Huliang2597/byd-music1/README.md

# byd-music1

- [显示器挂灯 DIY 制作方案（个人自制版 · 3D 打印）](docs/diy-monitor-light-bar.md)
- [显示器挂灯 3D 打印件（模型和 STL）](cad/README.md)
- [显示器挂灯 产品方案（量产版）](docs/monitor-light-bar-spec.md)
