Huliang2597/byd-music1/docs/monitor-light-bar-spec.md

# 显示器挂灯 产品方案（量产级 v1.0）

> 依据：原始需求 + 三条提问/批注。本文给出可直接进入 EVT 打样的完整方案，所有关键数值都附推导，标「待确认」的项需要在立项会上拍板。
> 器件型号为参考选型，量产前以方案商/原厂规格书和实测为准。

---

## 0. 结论速览（先回答三条提问）

| # | 提问 / 批注 | 结论 |
|---|---|---|
| 1 | 夹具样式？ | **背挂式重力夹（前挂钩 + 后配重臂 + 中间铰链）**，适配屏厚 0.6–3.0 cm、平面屏和 ≥1000R 曲面屏，不夹压面板；阻尼转轴放在灯体与夹具连接处，灯头俯仰 −10°～+25°。顶部带摄像头平台（1/4" 螺孔）的公模优先。详见 §2。 |
| 2 | 要不要氛围灯？装在哪？2812 加进去会超 5V1A | **做成 Pro 版选配，不进基础版。** 位置：**灯体背面朝后上方 30–45°**，打亮显示器后方墙面（Bias Light），用户正面看不到灯珠。功率靠“**分路硬件封顶 + 固件动态分配**”解决：前光硬件上限 655 mA，ARGB 支路硬件限流 ≤180 mA，两者加系统电流在 4.75 V 最坏情况下合计 ≤890 mA，**就算固件跑飞也不会超过 900 mA**。代价是 ARGB 全白最多约 11% 亮度、单色约 34%。作为背景光这个亮度刚好合适（Bias Light 本来就只需要屏幕亮度的 10% 左右）。详见 §4、§5。 |
| 3 | 蓝牙 +25、触摸 +20 | 按 BOM 估算，蓝牙模组含授权约 ¥6–9，触摸（IC + 电极 + CNC 开窗）约 ¥2–4。**批注里的成本若是方案商报价，偏高很多，建议要拆分报价。** 硬件设计成**一套 PCB 兼容 按键 / 触摸 / BLE / ARGB 选贴**，可以按 SKU 分开出货。详见 §7.4、§10。 |

**关键设计决策（摘要）**
1. 前光：48 颗双色温 2835（Ra95 料），**8 串 6 并**，接**一路升压恒流**。冷暖两路用**互补 PWM（重叠，不加死区）** 混色，亮度走**模拟（DC）调光**，所以没有频闪，换色温时总光通也不变。
2. 电源：USB-C 只做 5 V Sink（CC 各接 5.1 kΩ 下拉），输入端有软启动加短路保护，分支各有硬件上限，固件用分流电阻闭环测电流，带 VBUS 跌落自适应降额（兼容只给 500 mA 的 USB2 口）。
3. 无线：**只做 BLE，不做 Wi-Fi**。Wi-Fi 发射峰值约 300 mA 以上，会吃掉三分之一的功率预算，而手机控制用 BLE 已经足够。推荐涂鸦 BLE 模组走 MCU 串口协议，不用自己开发 App，上市最快。
4. 触摸：铝壳上做不了电容触摸，要在**右端顶面 CNC 开窗，嵌 PC 触控盖板**（或者用加长塑料端盖，成本更低）。

---

## 1. 产品定义与规格总表

### 1.1 SKU 规划（建议）

| 配置 | 基础版 | 标准版 | Pro 版 |
|---|---|---|---|
| 前光 3000–6000K Ra≥90 | ● | ● | ● |
| 操控 | 实体按键 ×4 | 电容触摸 ×4 | 电容触摸 ×4 |
| BLE 手机控制 | — | ○（可选） | ● |
| 背光 ARGB | — | — | ● |
| 环境光自动调光（ALS） | — | ○ | ○ |

> 三个版本共用铝型材、夹具、LED 板、电源板，只是控制板选贴不同；端盖或触控窗分两种镶件。

### 1.2 规格总表

| 项目 | 规格 |
|---|---|
| 外形 | 铝槽主体 450 ±0.3 mm，含端盖总长约 456 mm；截面约 26 × 22 mm（以公模图纸为准） |
| 前光有效发光长度 | 400 mm（两端各留 25 mm 放电源板和控制板） |
| 输入 | USB Type-C（Sink），5 V（4.75–5.25 V），**稳态 ≤ 850 mA（固件目标），任何工况 ≤ 900 mA，总功率 ≤ 4.5 W** |
| 前光光源 | 48 × 双色温 2835（3000K + 6000K，单芯 Ra95 / R9≥50），8S6P |
| 色温 | 3000–6000K 无级（App 步进 100K；按键 4 档 + 长按无级） |
| 显色 | 全色温段 Ra ≥ 90（目标 ≥ 92），R9 ≥ 50，Duv 在 ±0.006 以内 |
| 亮度 | 1%–100% 无级，按 CIE 感知曲线（Gamma）映射 |
| 照度目标 | 灯下 45 cm，中心 ≥ 500 lx（6000K 满亮），≥ 420 lx（3000K） |
| 频闪 | 亮度用 DC 调光；IEEE 1789 无风险级，SVM ≤ 0.4，Pst^LM ≤ 1 |
| 蓝光 | IEC/EN 62471（GB/T 20145）RG0 豁免级 |
| 防眩光 | 非对称配光；屏幕面中心由本灯产生的照度 ≤ 30 lx，正视屏幕看不到反射光带 |
| 背光 (Pro) | 20 × WS2812B-2020（或同协议同尺寸），间距 20 mm，朝后上方 30–45°，支路硬件限流 ≤ 180 mA |
| 操控 | 电容触摸 4 键（或实体按键 4 键），BLE 5.x 手机 App，预留实体按键/扩展口 |
| 夹具 | 背挂式重力夹，适配屏厚 0.6–3.0 cm，阻尼转轴俯仰 −10°～+25° |
| 待机功耗 | BLE 版 ≤ 0.05 W；无 BLE 版 ≤ 0.01 W |
| 工作环境 | 0–40 °C，RH ≤ 85% 无凝露；储存 −20–60 °C |
| 寿命 | L70 ≥ 25,000 h（按 TM-21 由 LM-80 数据推算），阻尼转轴 ≥ 5,000 次 |
| 附件 | USB-A 转 C 线 1.5 m（24AWG 电源线）、说明书、保修卡 |

---

## 2. 夹具方案（回答提问 1）

### 2.1 公模样式对比

| 样式 | 原理 | 优点 | 缺点 | 结论 |
|---|---|---|---|---|
| **A. 背挂式重力夹**（前挂钩 + 铰链 + 后配重臂） | 重心落在屏幕背面，靠自重挂在屏幕上沿，铰链自适应屏厚 | 不压面板；适配平面/曲面屏；安装一放即可；公模多 | 后配重臂会碰到屏幕背后凸起很大的机型 | **推荐** |
| B. 弹簧夹 | 弹簧夹住屏幕上沿 | 便宜 | 夹持力直接压在面板上，超薄屏、曲面屏容易压伤或漏光；夹持厚度范围小 | 不推荐 |
| C. 粘贴底座 + 磁吸 | 屏幕背面粘底座 | 最稳 | 要用胶，用户接受度低，拆卸会留胶 | 只作配件 |
| D. A 型 + 顶部摄像头平台 | A 型的夹具顶面做成平台，带 1/4" 螺孔 | 解决“挂灯后摄像头没地方放”的痛点 | 夹具贵 ¥1–2 | **A 型的优选款** |

### 2.2 选型要求（给夹具供应商的规格）

| 项目 | 要求 |
|---|---|
| 适配屏厚 | 0.6–3.0 cm（覆盖绝大多数平面屏；曲面屏 ≥ 1000R） |
| 前挂钩 | 下垂深度 ≤ 8 mm（不遮挡窄边框屏的显示区），厚度 ≤ 3 mm，内侧贴防滑硅胶垫（邵氏 40–50A，厚 1 mm） |
| 后配重臂 | 长度 ≥ 60 mm，接触面带硅胶垫；配重用锌合金或铁块，夹具总重 80–120 g |
| 稳定性 | 灯体加夹具的合重心必须落在屏幕前表面之后 ≥ 5 mm；装好后向前推 15° 不翻落 |
| 阻尼转轴 | 轴线平行于灯体长度方向；俯仰 −10°～+25°；扭矩 0.8 ±0.2 kgf·cm（推导见下）；寿命 ≥ 5,000 次后扭矩衰减 ≤ 30% |
| 灯体连接 | 卡箍或卡槽抱住铝型材中段（型材要有对应卡位），不能在铝面上留压痕 |
| 材料 | PC/ABS（UL94 V-2 及以上）+ 锌合金；表面颜色与铝型材一致 |
| 线缆 | USB 线**不穿过转轴**（避免反复扭转断线），从左端盖直接引出，沿屏幕背后走线 |

**阻尼扭矩推导**：灯体约 0.22 kg，绕转轴的重心偏心按 10 mm 估算，重力矩 = 0.22 × 9.8 × 0.01 ≈ 0.022 N·m ≈ 0.22 kgf·cm。取 3–4 倍安全系数（防止碰一下就掉角度，同时手调起来不费劲），得 0.8 ±0.2 kgf·cm。EVT 阶段用实物称重和实测重心后再修正。

---

## 3. 光学方案（前光）

### 3.1 光源

- **灯珠**：双色温 2835（单颗封装内一颗 3000K 芯 + 一颗 6000K 芯，4 脚），48 颗，间距 8.33 mm。
- **选料要求**：单色温 Ra ≥ 95、R9 ≥ 50。原因：3000K 和 6000K 混出的中间色温会落在普朗克轨迹下方（Duv 偏负），Ra 会掉 2–4 个点，所以单芯要用 95 的料，才能保证全段 ≥ 90。
- **分档**：同一批次同一 Vf 档（档宽 ≤ 0.1 V）、同一色区（3 阶麦克亚当椭圆以内）。Vf 一致决定 6 路并联的均流，色区一致决定整条灯色温均匀。
- **工作点**：单芯约 21 mA（额定 60 mA 的 35%），光效高、温升低、光衰慢。

### 3.2 非对称配光（防屏幕眩光）

挂灯的核心体验：**光只往桌面和键盘区打，不打到屏幕上**。用公模做的实现方式：

1. LED 板在型材里**向用户方向前倾 20°±5°** 安装（型材里要有斜卡槽，选公模时重点核对）。
2. 型材**后侧做 3–5 mm 遮光唇**，挡住射向屏幕的后向光。
3. 前侧做短遮光檐，防止用户直视灯珠（坐姿视线高于灯底面时看不到发光面）。
4. 扩散罩用高雾度 PC（透过率 75–85%，雾度 ≥ 90%）。灯珠到罩的距离 ≥ 6 mm，才能消除 8.3 mm 间距带来的颗粒感。
5. 有条件的可以做微棱镜 PC 罩，压窄光束，更不容易溢光到屏幕上；这属于升级项，要开挤出模。

**验证指标**：显示器 24" 和 27" 两种工况，45 cm 坐姿，屏幕中心照度增量 ≤ 30 lx，熄屏状态下正视屏幕看不到反射光带。

### 3.3 混光与调光原理

```
            ┌────────── 升压恒流 (总电流 I_total 由 DIM 设定, DC 调光) ──────────┐
VBUS 5V ──► │ BOOST ──► V_out ≈ 23 V ──┬── 6 串暖白芯 (8S6P) ── Q_W ──┐          │
            │                          └── 6 串冷白芯 (8S6P) ── Q_C ──┴─ R_sense ─┘
            └──────────────────────────────────────────────────────────────────────┘
   MCU: DIM (PWM→模拟)  → 总亮度
        PWM_W / PWM_C (25 kHz 互补, 重叠 0.2–0.5 µs) → 色温比例 D : (1−D)
```

- **同一时刻只有一路导通**，升压的负载恒定，所以换色温时总功率不变，输入电流不会跳。
- 互补 PWM **用重叠，不用死区**：两路同时关断时恒流环会开路，触发 OVP 尖峰；两路短暂同时导通只是分流，没有坏处。
- PWM 频率 25 kHz：高于可闻频段（陶瓷电容不会啸叫）。暖芯冷芯光效有差别，会带来残余调制，但在这个频率下属于 IEEE 1789 无风险区。
- 亮度用 DC（模拟）调光，1% 以下才切到低频 PWM 补偿，消费者感知层面算“无频闪”。
- **等光通色温**：暖芯光效比冷芯低约 10–15%，固件里存一张色温 → 电流补偿表（产测时校准），保证在 3000K 和 6000K 之间切换时亮度看起来一样。

### 3.4 照度可行性估算

LED 电功率上限 2.8 W，Ra95 料在这个电流下光效约 125 lm/W，得 350 lm；扩散罩加遮光损失约 20%，出光约 280 lm。非对称光束集中在约 60 × 35 cm 的桌面区，利用率按 0.6 计，平均照度约 800 lx，中心 ≥ 500 lx 有裕量。**EVT 阶段要用配光曲线仪实测确认。**

---

## 4. 背光氛围灯方案（回答提问 2）

### 4.1 要不要做

- **功能价值**：真正有用的是 Bias Light（屏后背景光），它能降低屏幕和暗墙之间的明暗反差，减轻暗室用屏的视疲劳；RGB 灯效主要是电竞桌搭的颜值卖点。
- **建议**：**只在 Pro 版做**。基础版和标准版不贴 ARGB，PCB 和型材共用（背光罩改成同色盲条）。
- **默认模式设为“护眼背光”**：6500K 近似白、10–20% 亮度；RGB 灯效（流水、呼吸、静态色）作为可选模式。

### 4.2 位置

```
          用户 ◄────────── 前                     后 ──────────► 墙
                       ┌──────────────────────────┐
                       │      铝型材 (顶面)        │  ╲ 背光 PC 罩
          遮光檐 ─┐     │                          │   ╲  ARGB 朝后上方 30–45°
                  └──── │  前倾 20° LED 板          │    ↗↗  打亮显示器后方墙面
                       └──┬──── 扩散罩 ────┬──────┘
                          ↓↓  光打向桌面    └ 后遮光唇（挡屏幕方向的光）
                    ═══════════ 显示器上沿 ═══════════
```

- 在灯体**背面**开一条独立灯槽（要求公模是“双面出光”型材，**选型时必须确认**），装 ARGB FPC 和乳白 PC 罩。
- 朝向后上方 30–45°：光打到显示器后上方的墙面，用户坐姿看不到灯珠，也不会照进眼睛或打到屏幕上。
- 灯珠：WS2812B-2020（2 × 2 mm，适配窄槽），20 颗，间距 20 mm，覆盖 400 mm。

### 4.3 功率问题怎么解决

你的判断是对的：WS2812B 单颗全白约 60 mA（每通道约 20 mA），20 颗全白就是 1.2 A，单这一路就超过整机预算。方案如下：

1. **硬件封顶**：ARGB 的 5 V 走一颗**可调限流负载开关**（TPS2553 / SY6280 类，限流设定 ≈160 mA，最大 ≤180 mA）。固件失效时 ARGB 也吃不到 180 mA 以上。关闭氛围灯时直接断电，顺带消掉 20 颗灯珠的静态电流（约 10–20 mA）。
2. **固件封顶 150 mA**：固件按 `I ≈ N × I_q + Σ(R+G+B)/255 × I_ch` 估算电流（I_ch 产测时标定），超出就整体等比缩放亮度。
3. **能做到的亮度**：150 mA 扣掉静态电流后约 135 mA 可用，相当于全白约 11%、单色约 34%。作为背景光这已经够亮；墙面亮度太高反而会刺眼。
4. **如果市场要求更亮的 ARGB**（待确认）：可以换成“ARGB 硬件限流 300 mA + 前光硬件上限降到 2.3 W”的配置，代价是前光照度下降约 18%。不建议这样做。

### 4.4 电平兼容（容易踩的坑）

WS2812B 在 5 V 供电时 VIH = 0.7 × VDD = 3.5 V，**3.3 V 的 MCU 直接驱动处在临界区**，低温或者 VBUS 偏高时会乱码。必须加一颗 **74AHCT1G125**（5 V 供电，TTL 输入电平），串 33 Ω 电阻后再进第一颗灯。每颗灯珠旁放 100 nF 去耦电容。

---

## 5. 电源架构与功率预算（核心）

### 5.1 USB-C 输入

| 项目 | 设计 |
|---|---|
| 角色 | Sink only，CC1 / CC2 各接 **5.1 kΩ 下拉（Rd）**。不接的话 C-to-C 线插充电头不会出电，这是最常见的设计缺陷 |
| 连接器 | 6P 或 16P 卧式 Type-C 母座，插拔寿命 ≥ 10,000 次（6P 只有 VBUS/GND/CC，够用且更便宜） |
| 来源识别 | MCU 的 ADC 读 CC 电压：0.25–0.61 V 为 Default USB，0.70–1.16 V 为 1.5 A，1.31–2.04 V 为 3.0 A。即使检测到 1.5 A 或 3 A，**也按规格封顶 900 mA** |
| 浪涌 | USB 规范要求上电瞬间 VBUS 端容值 ≤ 10 µF：VBUS 口只放 4.7 µF，后级大电容放在带软启动的负载开关后面 |
| 保护 | VBUS 上放 TVS（5 V 单向，如 SMF5.0A），CC 和 D± 上放 ESD 阵列；输入负载开关带软启动和短路保护（约 1.1 A 动作，自动重试） |
| 电流检测 | 50 mΩ 分流电阻 + INA180A2（增益 50）→ ADC，900 mA 对应 2.25 V；分流电阻损耗 40 mW |
| 电压检测 | VBUS 经 100k/100k 分压 → ADC |

### 5.2 “硬件 + 固件 ≤ 900 mA”的实现

**这里需要统一对规格的理解**：在输入端放一个精确卡在 900 mA 的 eFuse，会因为器件 ±10% 的公差频繁误动作（用户看到的就是灯一闪一闪）。所以本方案这样实现“硬件限流 ≤ 900 mA”：

> **每条支路各自有硬件上限，最坏工况（VBUS 4.75 V、固件跑飞）下三路合计 ≤ 900 mA**；输入负载开关只负责短路保护；固件闭环把稳态电流控制在 850 mA 以内。

| 负载 | 硬件上限手段 | VBUS = 5.00 V | VBUS = 4.75 V |
|---|---|---|---|
| 系统（MCU + BLE + 触摸 + LDO + 指示灯） | — | 20 mA | 20 mA |
| 前光（LED 2.8 W 输出 + 镇流 0.05 W，升压 η ≈ 87%） | R_sense 定死 LED 最大电流 | 655 mA | 690 mA |
| 背光 ARGB（Pro） | 限流开关 ≤ 180 mA | 150 mA（固件上限） | 150 mA |
| **合计，固件正常** | | **825 mA / 4.13 W** ✓ | 860 mA → 固件把前光压到约 98%，回到 850 mA |
| **合计，固件失效最坏** | | 855 mA ✓ | **890 mA ✓（≤ 900）** |

推导：前光输入功率 = (2.8 + 0.05) / 0.87 = 3.28 W；在 5.00 V 下为 655 mA，在 4.75 V 下为 690 mA。

### 5.3 固件功率仲裁

- 10 ms 周期读一次输入电流，PI 闭环。目标 ≤ 850 mA，优先级：**系统 > 前光 > ARGB**（用户主动调 ARGB 时，先在 ARGB 自身 150 mA 上限内缩放，不去抢前光）。
- **VBUS 跌落自适应（兼容 USB2 口 500 mA）**：显示器上的 USB-A 口很多是 USB2（500 mA），线里的 56 kΩ 上拉只能告诉设备是“Default”，区分不了 500 mA 和 900 mA。所以：
  - VBUS < 4.60 V 持续 200 ms：前光每 100 ms 降 5%，直到 VBUS 回到 4.65 V 以上；
  - VBUS < 4.40 V：直接进入 **500 mA 兼容档**（前光 ≤ 380 mA，约 58% 亮度；ARGB ≤ 80 mA），指示灯慢闪 3 次提示；
  - 兼容档会被记住，下次上电按兼容档启动，30 s 后再试探性升档。
- 用户也能手动切“低功耗模式”（App 开关，或 K1 + K3 长按 3 s）。
- **过温**：LED 板中部放 NTC，> 65 °C 开始线性降额，> 80 °C 关前光（按估算，正常不会触发）。

### 5.4 电源树

```
USB-C VBUS ─ TVS ─ 分流 50 mΩ ─ 输入负载开关(软启动/短路保护) ─┬─ 升压恒流 ── 前光 8S6P ×2 路
                                                              ├─ 限流开关 ≤180 mA ── ARGB ×20 (Pro)
                                                              └─ LDO 3.3 V (ME6211) ── MCU / BLE / 触摸 / 运放
```

- 3.3 V 支路只有约 20 mA，用 LDO（ME6211C33）就够，比 Buck 便宜也更安静。**如果以后要做 Wi-Fi 版，必须换 Buck**（Wi-Fi 峰值 300 mA 以上）。
- **关灯微亮（鬼火）**：升压关断后 VOUT ≈ VBUS ≈ 5 V，而 8 串 LED 的 Vf ≈ 23 V，所以完全不会导通，从拓扑上消除了鬼火。

---

## 6. 电子硬件设计

### 6.1 系统框图

```
┌────────────── 左端 25 mm：电源板 (FR4 2L 1.0 mm) ──────────────┐   ┌──── 400 mm LED 铝基板 (1.0 mm, 单面) ────┐
│ USB-C 6P │ TVS/ESD │ 分流+INA180 │ 负载开关 │ 升压恒流 + 电感 │──►│ 48 × 双色温 2835, 8S6P × 2 路, 镇流电阻, NTC │
│ CC 5.1k×2 │ VBUS 分压 │ 3.3 V LDO │ Q_W / Q_C / R_sense         │   └─────────────────────────────────────────┘
└───────────────▲──────────── 8P 0.5 mm FFC / 线束 ──────────────┘
                │ 3V3, GND, DIM, PWM_W, PWM_C, ISENSE, VBUS_S, NTC
┌───────────────┴─ 右端 25 mm：控制板 (FR4 2L 1.0 mm) ─────────────────────────────┐
│ MCU (PY32F003) │ BLE 模组 (UART, 选贴) │ 触摸 IC 4 键 (选贴) / 实体按键焊盘 │ 指示灯 ×4 │
│ 74AHCT1G125 + ARGB 限流开关 (选贴) ──► 背面 ARGB FPC 20 × WS2812B-2020           │
│ SWD 测试点 │ 扩展口焊盘 (2 × GPIO + 3V3 + GND, 用于外接按键/旋钮)                  │
└────────────────────────────────────────────────────────────────────────────────┘
```

> 电源板和控制板分别放在两端，也让整灯左右重量基本平衡，挂在夹具上不会往一边偏。

### 6.2 关键器件选型（参考）

| 功能 | 参考型号 | 关键参数 / 理由 | 国产替代 |
|---|---|---|---|
| 主控 MCU | PY32F003（Cortex-M0+ 32 MHz） | 定时器互补 PWM、SPI（模拟 WS2812 时序）、12 位 ADC × 4、UART；单价 ¥0.3–0.6 | 本身即国产；或 CH32V003、STM32G030 |
| 升压恒流 | TPS61169 类 | 输入 2.7 V 起，开关管 40 V / 1.2 A，OVP 约 38 V，CTRL 脚 PWM 转模拟调光，FB 0.2 V | 由方案商确认 pin-to-pin 国产料 |
| R_sense | 1.6 Ω 1% 0805 | 0.2 V / 125 mA，**决定前光硬件上限** | — |
| 电感 | 10 µH，I_sat ≥ 1.5 A，DCR ≤ 100 mΩ，4 × 4 mm | 高度 ≤ 3 mm（受型材内腔限制） | 顺络、麦捷 |
| 整流管 | SS14 / 40 V 1 A 肖特基 | — | — |
| 输出电容 | 2.2 µF / 50 V X7R × 2 | 耐压按 OVP 选 | — |
| 色温开关 Q_W / Q_C | 30 V N-MOS，SOT-23，R_DS(on) ≤ 100 mΩ @ 2.5 V | 由 MCU 3.3 V 直接驱动 | AO3400 类 |
| 输入负载开关 | 带软启动的 USB 限流开关，约 1.1 A | 短路保护、控制浪涌 | 矽力杰 / 韦尔 |
| ARGB 限流 | TPS2553 / SY6280 类可调限流开关，≈160 mA | 硬件封顶 + 关断时断电 | — |
| 电流检测 | INA180A2 + 50 mΩ 1% | 分流电压放大 | 圣邦微、思瑞浦 |
| LDO | ME6211C33 | 500 mA，Iq 约 40 µA | — |
| 触摸 IC | 4 键触摸 IC（TTP224 或合泰 BS83A04A 类） | 自校准、灵敏度可调、带防水算法的优先 | 本身即国产 |
| BLE | 涂鸦 BLE 模组（Telink TLSR825x 方案） | 发射电流约 10 mA 级，涂鸦 MCU 串口协议，自带 App，支持 OTA | 也可用 ESP32-C3（要自研 App） |
| 电平转换 | 74AHCT1G125 | 3.3 V → 5 V，驱动 WS2812 | — |
| ARGB 灯珠 | WS2812B-2020 × 20 | 窄槽；电流以规格书为准，预算按 20 mA/通道保守计算 | 晶能、普瑞等同协议灯珠 |
| NTC | 10 kΩ B3950 0603 | 放在 LED 板中部 | — |

### 6.3 LED 铝基板

- 尺寸 400 × 8–10 mm（宽度按型材卡槽定），1.0 mm 厚铝基，导热 ≥ 1.0 W/m·K，单面；白油。
- 走线：每颗双色温灯珠的暖芯和冷芯分属两路；6 个并联串**按空间交错排布**，这样即使某一串偏暗，也是均匀分散的，不会出现一段暗区。
- 每串串 20 Ω 镇流电阻（20 mA 时压降 0.4 V，功耗 8 mW），配合同一 Vf 档，均流误差可以压到 ±5% 以内。
- 端子：两端焊盘直接焊线（或板对线连接器）接电源板，NTC 信号也走这条线。

### 6.4 PCB 设计要点 checklist

- [ ] 升压环路（开关管 → 电感 → 二极管 → 输出电容 → 地）面积最小，地平面完整，FB 走线远离电感。
- [ ] R_sense 用开尔文连接；用 1% 精度；它决定硬件上限，BOM 里标成**关键件，禁止替代**。
- [ ] CC 下拉 5.1 kΩ 用 1%。
- [ ] 触摸电极：8 × 8 mm，键间距 ≥ 15 mm，电极距离铝壳 ≥ 3 mm，触摸走线最短，不与 PWM 走线平行；敷铜用网格地。
- [ ] 铝壳通过 USB 外壳接 GND（ESD 泄放路径），触摸 IC 的灵敏度在装壳后标定。
- [ ] 控制板上 BLE 天线的净空区（按模组手册）要对准塑料件区域，**不能被铝壳包住**（天线位置放到触控窗或端盖下方，否则距离会掉到 1–2 m）。
- [ ] 预留 SWD、UART 测试点，以及产测针床定位孔。

---

## 7. 操控与交互

### 7.1 触摸区位置

铝是导体，**没法隔着铝壳做电容触摸**。两个方案：

| 方案 | 做法 | 成本 | 外观 |
|---|---|---|---|
| **A（推荐）** | 右端顶面 CNC 铣窗 70 × 10 mm，嵌入 1.5 mm 厚 PC 触控盖板（背面丝印图标，透光孔下面放指示灯） | CNC ¥1–2 + 盖板 ¥0.5 | 一体感强，接近一线品牌 |
| B（降本） | 右端盖加长做成 30 mm 的塑料件，触摸键做在端盖顶面 | ≈ ¥0 增量（改端盖模） | 端盖较长，按键较挤 |

基础版：同一位置换成实体按键盖板，下面放 4 颗 3 × 4 mm 侧按/顶按轻触开关（寿命 ≥ 100,000 次）。

### 7.2 按键定义（触摸版与实体按键版逻辑一致）

| 键 | 短按 | 长按 | 其他 |
|---|---|---|---|
| K1 ⏻ 电源 | 开/关（300 ms 渐变） | 5 s：进入 BLE 配网（指示灯快闪） | K1 + K2 长按 8 s：恢复出厂 |
| K2 ☀ 亮度 | 循环 20 / 50 / 80 / 100% | 无级调光，每次长按方向交替，到顶/到底闪一下 | — |
| K3 🌡 色温 | 循环 3000 / 4000 / 5000 / 6000K | 无级调色温，方向交替 | K1 + K3 长按 3 s：低功耗模式开/关 |
| K4 ✦ 氛围灯（Pro） | 开/关 | 调氛围灯亮度 | 双击：切换模式（护眼背光 → 静态色 → 呼吸 → 流水） |

- **防误触**：按住 50 ms 才判定有效；≥ 3 个键同时触发视为擦拭或手掌误触，直接忽略；上电后 1 s 内触摸 IC 自校准，期间不响应。
- **指示灯**：每键下面一颗 0603 暖白 LED，≤ 1 mA，开灯后 5 s 自动降到 10% 亮度（避免夜间刺眼），可以在 App 里关掉。

### 7.3 手机端（BLE）

**推荐方案：涂鸦 BLE 模组 + MCU 串口协议**（MCU 负责全部灯控逻辑，模组只做透传和云端/App 对接）。

- 优点：不用开发 App（用“涂鸦智能 / 智能生活”App，也可以做自有品牌 OEM App）；自带 OTA、定时、场景；可以接入涂鸦生态的语音音箱联动（通过网关）。
- DP 点规划（参考涂鸦照明品类标准 DP，以平台最新定义为准）：

| DP | 功能 | 类型 | 范围 |
|---|---|---|---|
| 20 switch_led | 前光开关 | bool | — |
| 21 work_mode | 模式（白光/场景） | enum | white / scene |
| 22 bright_value | 前光亮度 | value | 10–1000 |
| 23 temp_value | 色温 | value | 0–1000（映射 3000–6000K） |
| 25 scene_data | 场景（阅读/办公/观影/夜间） | string | — |
| 26 countdown | 倒计时关灯 | value | 0–86400 s |
| 自定义 | 氛围灯开关 / 模式 / 颜色 / 亮度 / 速度 | bool / enum / string / value | — |
| 自定义 | 低功耗模式、指示灯开关、休息提醒（每 45 min 闪一下提醒起身） | bool / value | — |

- 备选方案 1：ESP32-C3 单芯片（BLE 加可选 Wi-Fi）加自研小程序/App，适合要做自有生态的情况，开发周期多 6–8 周。
- 备选方案 2：米家生态，需要走小米认证和合作流程，周期长，适合有渠道资源的情况。

### 7.4 关于“蓝牙 +25 / 触摸 +20”的成本批注

| 项 | 批注 | 本方案 BOM 估算 | 说明 |
|---|---|---|---|
| 蓝牙 | +25 | ¥6–9 | 模组 ¥5–7 + 涂鸦授权约 ¥1 + 天线净空带来的结构影响 ≈ 0；另有一次性费用：SRRC/认证、OEM App 开通 |
| 触摸 | +20 | ¥2–4 | 触摸 IC ¥0.3–0.8 + 电极/盖板 ¥0.5–1 + CNC 开窗 ¥1–2 |

- 如果 +25 / +20 是**零售价增量**，那是合理的定价策略；如果是**方案商的成本报价**，建议按上表要求拆分报价，或者改为自研硬件、只采购模组。
- 实体按键成本约 ¥1–2，适合基础版。三个版本共用控制板，只是选贴不同，**不额外开板**。

---

## 8. 固件设计

### 8.1 模块

| 模块 | 内容 |
|---|---|
| 启动 | 上电 → 读 Flash 配置 → 读 CC 和 VBUS 判断来源 → 触摸自校准 → 按“掉电记忆”恢复上次状态（可设为默认关灯） |
| 灯控 | 亮度 Gamma 表（CIE 1931 L*）、色温混光比 D 的查表、等光通补偿表（产测写入）、300 ms 渐变、1% 以下低亮补偿 |
| 功率仲裁 | 10 ms PI 环，见 §5.3 |
| ARGB | SPI 输出 WS2812 时序（2.4–3.2 MHz SPI，每 bit 用 3–4 个 SPI bit 编码），30 fps 刷新；功率模型缩放；关闭时断电 |
| 输入 | 触摸 IC 输出（或按键 GPIO）去抖、短按/长按/双击/组合键状态机 |
| 通信 | 涂鸦 MCU 串口协议（9600 / 115200 bps），心跳、DP 上报、配网、OTA（模组 OTA + MCU 固件经模组透传升级） |
| 存储 | Flash 模拟 EEPROM，磨损均衡；最后一次操作 3 s 后才写入 |
| 保护 | 过流（> 1 A 立即关输出后重试）、过温降额、VBUS 欠压降额/兼容档、看门狗 |
| 产测模式 | 上电 2 s 内串口收到特定指令进入：逐路点亮、写校准系数、读传感器、测 BLE RSSI |

### 8.2 状态与默认值

- 出厂默认：4000K、70% 亮度、ARGB 关、指示灯开、掉电记忆开。
- 自动关灯：可选 2 h / 4 h / 关闭（App 设置），默认关闭。

---

## 9. 结构设计

### 9.1 铝型材（公模选型要点）

选公模型材时**必须逐条核对**，不满足的就要开私模（私模挤出模约 ¥3,000–8,000，周期 2–3 周，比较便宜，可以考虑）：

- [ ] 外形约 26 × 22 mm 以内，壁厚 ≥ 1.0 mm，材料 6063-T5。
- [ ] 底部有**前倾 15–25° 的 LED 板卡槽**和扩散罩卡槽。
- [ ] 后侧有遮光唇（3–5 mm）。
- [ ] Pro 版需要**背面第二灯槽**（双面出光型材）。
- [ ] 内腔能放下 25 mm 长、高度 ≤ 4 mm 器件的控制板和电源板。
- [ ] 中段有夹具卡位（或卡箍能抱住的外形）。
- [ ] 表面处理：喷砂 + 阳极氧化（深空灰/银/黑），膜厚 ≥ 10 µm，中性盐雾 24 h 无腐蚀。
- [ ] 直线度 ≤ 0.5 mm / 450 mm，切口无毛刺；触控窗由 CNC 加工，开窗后再氧化。

### 9.2 其他结构件

| 件 | 材料 / 工艺 | 要点 |
|---|---|---|
| 前光扩散罩 | 挤出 PC，雾度 ≥ 90%，透过率 75–85%，UL94 V-2 | 和型材长度一致，两端由端盖压住 |
| 背光罩（Pro） | 挤出乳白 PC | 非 Pro 版换成同色盲条 |
| 左端盖 | PC/ABS 注塑，UL94 V-0 | USB-C 开孔，与母座间隙 ≤ 0.2 mm；用卡扣加 1 颗自攻螺钉固定，防止插拔时把端盖带出来 |
| 右端盖 | PC/ABS 注塑 | 方案 B 时加长并集成触摸面 |
| 触控盖板 | PC 1.5 mm，背面丝印 + 透光孔 | 用 3M 双面胶加卡位固定，平面度 ≤ 0.1 mm（影响触摸灵敏度一致性） |
| 夹具 | 公模，见 §2 | 来料检验扭矩和配重 |
| 内部固定 | 控制板和电源板插入型材内槽，背面贴导热/缓冲泡棉 | 敲击无异响 |

### 9.3 重量目标

灯体约 200–230 g（型材约 135 g、罩约 20 g、PCB 约 30 g、端盖约 15 g、其他约 20 g），夹具 80–120 g，整机 ≤ 350 g。

---

## 10. BOM 与成本估算（1k–5k 量级，含税估算，仅供立项参考）

| 类别 | 项目 | 基础版 | 标准版 | Pro 版 |
|---|---|---|---|---|
| 结构 | 铝型材 450 mm + 氧化（+ CNC 开窗） | 6–8 | 7–9 | 7.5–9.5（双槽型材） |
| 结构 | 扩散罩 / 背光罩 / 端盖 ×2 / 盖板 | 2.5–3.5 | 3–4 | 3.8–5 |
| 结构 | 重力夹具（公模，含配重、硅胶、阻尼） | 8–15 | 8–15 | 8–15 |
| 光源 | LED 铝基板 + 48 颗双色温 2835 Ra95 | 5–8 | 5–8 | 5–8 |
| 电子 | 电源板（USB-C、保护、升压、检测、LDO） | 4–6 | 4–6 | 4–6 |
| 电子 | 控制板（MCU、按键或触摸、指示灯） | 1.5–2.5 | 2–3.5 | 2–3.5 |
| 电子 | BLE 模组 + 授权 | — | (6–9) | 6–9 |
| 电子 | ARGB（20 颗 + FPC + 限流开关 + 电平转换） | — | — | 4–6 |
| 附件 | USB-A 转 C 线 1.5 m | 2–3 | 2–3 | 2–3 |
| 包装 | 彩盒、内托、说明书、保修卡 | 3–5 | 3–5 | 4–6 |
| 制造 | SMT、组装、产测、老化、良损 | 4–6 | 4–6 | 5–7 |
| **合计** | | **≈ ¥36–57** | **≈ ¥38–60**（含 BLE ¥44–69） | **≈ ¥51–78** |

> 一次性费用（不计入单价）：认证（见 §11）约 ¥3–6 万；私模型材（如需要）¥0.3–0.8 万；端盖注塑模 ¥1–2 万；产测治具 ¥0.5–1 万；涂鸦 OEM App（可选）按平台报价。

---

## 11. 认证与测试

### 11.1 认证（按销售市场勾选，待确认）

| 市场 | 项目 |
|---|---|
| 中国 | SRRC 型号核准（BLE 版，选已认证模组可以简化流程）；灯具安全/EMC 按 GB 7000.1、GB 7000.201、GB/T 17743 自测或做 CQC 自愿认证；RoHS；**CCC 是否适用，要按最新目录和 USB 低压供电的情况向检测机构确认** |
| 欧盟 | CE：EMC（EN 55015 / EN 61547）、RED（EN 300 328、EN 301 489-1/-17，BLE 版）、EN 60598-1 / -2-1、EN 62471、RoHS、ErP（待机） |
| 美国 | FCC Part 15B（基础版）/ 15C（BLE 版）；可选 UL 153 / UL 8750 |
| 其他 | 日本 TELEC、韩国 KC 等按需 |

### 11.2 设计验证（DVT）测试清单

| 类别 | 项目 | 判定 |
|---|---|---|
| 光学 | 照度分布（45 cm 平面，10 cm 网格） | 中心 ≥ 500 lx，60 × 30 cm 区域均匀度 ≥ 0.6 |
| 光学 | 色温 / Ra / R9 / Duv（3000/3500/…/6000K 共 7 点） | Ra ≥ 90、R9 ≥ 50、Duv ±0.006，色温误差 ±150K |
| 光学 | 屏幕溢光 | 屏幕中心照度增量 ≤ 30 lx，熄屏时无反射光带 |
| 光学 | 频闪（全亮度段扫描） | SVM ≤ 0.4，Pst^LM ≤ 1 |
| 光学 | 蓝光危害 | RG0 |
| 电气 | 输入电流：全亮度 × 全色温 × ARGB 全模式 × VBUS 4.75/5.0/5.25 V | 稳态 ≤ 850 mA，峰值 ≤ 900 mA |
| 电气 | 故障注入：MCU 复位保持 / DIM 和 PWM 强拉高 / ARGB 数据全白 | ≤ 900 mA（验证硬件封顶） |
| 电气 | USB2 500 mA 口、各类笔记本 / 显示器 / 充电头（≥ 20 款）兼容性 | 不掉电、不闪烁，能正确进入兼容档 |
| 电气 | C-to-C 线 + PD 充电头 | 能出电（验证 5.1 kΩ Rd） |
| 电气 | ESD IEC 61000-4-2 | 接触 ±6 kV / 空气 ±8 kV 判 A 级（触摸区和 USB 口重点打） |
| 电气 | 短路、LED 开路（OVP）、热插拔 1,000 次 | 不损坏、自动恢复 |
| 热 | 25 °C 和 40 °C 环境满功率 4 h | 外壳 ≤ 45 °C（手可接触面），LED 焊点 ≤ 75 °C |
| 无线 | BLE 距离（灯挂在显示器上） | 开阔环境 ≥ 10 m |
| 触摸 | 灵敏度一致性、手汗/湿手、充电器共模干扰（3 Vrms，IEC 61000-4-6） | 无误触，无漏触 |
| 可靠性 | 高温高湿 40 °C / 93% RH 96 h、高低温循环 −20～60 °C 20 次 | 功能正常，外观无异常 |
| 可靠性 | 阻尼转轴 5,000 次、夹具开合 3,000 次、USB 插拔 5,000 次、按键 100,000 次 | 扭矩衰减 ≤ 30%，功能正常 |
| 可靠性 | 包装跌落（ISTA 1A）、运输振动 | 无损坏、无异响 |
| 寿命 | LED 光衰（LM-80 数据 + 整灯 1,000 h 点亮） | L70 ≥ 25,000 h |

---

## 12. 生产与产测

### 12.1 工艺流程

```
来料检验 (LED 分档/夹具扭矩/型材尺寸与膜厚) → SMT (LED 铝基板, 电源板, 控制板)
→ MCU 烧录 + BLE 授权写号 → 板级 ICT/FCT → 总装 (板入型材, 罩, 端盖, 盖板)
→ 整机 FCT → 老化 (满功率 4 h, 循环开关) → 整机复测 → 外观检 → 包装 (夹具分装)
```

### 12.2 整机 FCT 治具（每台都测，单台节拍 ≤ 30 s）

1. 4 个工况下输入电流（关灯 / 3000K 100% / 6000K 100% / Pro 版前光 100% + ARGB 全白），和标准值比较，偏差 ±5%。
2. 照度和色温点检：治具暗箱里放照度计 + 色彩传感器，测 3000K 和 6000K 两点，并**写入等光通补偿系数**。
3. ARGB：相机或色彩传感器检测 R / G / B / 白四种画面，确认无死灯。
4. 触摸：铜柱模拟手指逐键点按，读取触摸 IC 的原始值，确认在窗口内。
5. BLE：读 RSSI，确认在标准值 ±6 dB 以内，并确认授权码写入成功。
6. 掉电记忆：设置后断电再上电，确认状态正确。

### 12.3 关键质量控制点

- LED：每批核对 Vf / 色区分档标签，**禁止混档**；首件做积分球测试。
- R_sense、CC 下拉电阻、限流开关的限流电阻列为关键件，替代必须走 ECN 并重测 §11.2 的电流项。
- 夹具：每批抽检扭矩（0.8 ±0.2 kgf·cm）和挂钩下垂深度。

---

## 13. 开发计划（参考，约 14–16 周到量产）

| 阶段 | 周期 | 产出 |
|---|---|---|
| 立项 / 选型 | W1–W2 | 敲定 §14 待确认项；锁定型材和夹具公模；索取 LED 样品和规格书 |
| EVT | W3–W6 | 原理图 + PCB 第一版、手板（公模加 CNC）；光学实测，调整 LED 前倾角和遮光唇；功率预算实测 |
| DVT | W7–W10 | PCB 第二版、端盖模具 T1、固件功能完整、App 面板；§11.2 全项测试；送认证 |
| PVT | W11–W13 | 小批量 200–500 台试产，验证治具、节拍、良率（目标 ≥ 97%） |
| MP | W14+ | 量产 |

---

## 14. 待确认项（立项会清单）

| # | 事项 | 建议 |
|---|---|---|
| 1 | SKU 组合与目标零售价 | 三档：基础 / 标准 / Pro |
| 2 | 是否保留 ARGB；ARGB 亮度上限取 180 mA 还是 300 mA | Pro 版保留，180 mA |
| 3 | 无线方案：涂鸦 BLE / ESP32-C3 自研 / 米家；是否需要 Wi-Fi | 涂鸦 BLE，不做 Wi-Fi |
| 4 | 触摸位置：CNC 开窗 / 加长端盖 | CNC 开窗 |
| 5 | 型材：现有公模是否满足 §9.1；是否开私模 | 先找双面出光公模，找不到就开私模 |
| 6 | 夹具：是否要摄像头平台款 | 要 |
| 7 | 是否加环境光传感器自动调光（+¥1–1.5） | 标准版和 Pro 版可选 |
| 8 | 销售市场与认证范围 | 先做国内 + CE / FCC |
| 9 | 外观颜色、包装风格、品牌丝印 | — |
| 10 | 批注中“蓝牙 +25、触摸 +20”的口径（成本还是零售价） | 如果是成本，要求方案商拆分报价 |
