Huliang2597/byd-music1/docs/diy-monitor-light-bar.md

# 显示器挂灯 DIY 制作方案（个人自制版 · 3D 打印）

> 目标：一个人在家做出来。电子零件和铝槽在淘宝 / 拼多多零售买，夹子、卡座、电控仓、堵头、背光导轨用自己的 3D 打印机打印。不开模、不打 PCB、不写代码。
> 前提：会用电烙铁焊导线；有一台 3D 打印机和一把卡尺；有一台装了 Chrome 或 Edge 浏览器的电脑；买一个 USB 电流表（用来确认整灯不超过 900 mA）。
> 价格为参考价，以实际购买为准。
> 打印件的模型文件：`cad/monitor-light-bar.scad`（参数化，按你量的尺寸生成 STL），默认尺寸的 STL 在 `cad/stl/`。

---

## 0. 一页看懂

**做法**：45 cm 铝槽当灯体，两端和夹子用 3D 打印，电路全部装进打印的电控仓。

- **灯体**：U 型 LED 铝槽 + 乳白灯罩，切 45 cm（照原需求）。
- **打印件**：重力夹、灯体卡座（带阻尼转轴）、电控仓 + Type-C 端盖、右堵头、背光导轨。夹子按你自己显示器的厚度生成，挂上去不晃。
- **主控**：ESP32-C3 SuperMini 小板，刷开源固件 **WLED**。手机浏览器或 WLED App 控制，自带灯效、场景、定时、夜灯，不用写代码。
- **前光**：5V 双色温 COB 灯带 40 cm（Ra ≥ 90），两颗 MOS 管分别调暖白和冷白。
- **背光**（可选）：WS2812B 灯带 20 颗，装在打印的斜导轨上，朝后上方打亮墙面。
- **按键**：两个 TTP223 触摸模块贴在电控仓顶面内侧；电控仓是塑料的，Wi-Fi 信号也好。另留一个接口接实体按钮。
- **供电**：电控仓端面一个 Type-C 口。自恢复保险丝、限流电阻和 WLED 限流三层控制电流，再用 USB 电流表实测确认 ≤ 900 mA。

| 项目 | 估计 |
|---|---|
| 零件费用 | ¥90–170（铝槽 + 电子件 + 线材小件） |
| 打印耗材 | PETG 约 70–90 g（约 ¥5–10），机器打印时间合计 6–9 小时 |
| 工具（家里没有的话） | ¥150–250（电烙铁、万用表、USB 电流表、卡尺、热熔胶枪等） |
| 制作时间 | 零件到齐后一个周末：刷机 1 h、量尺寸和试配件 1 h、桌面试接 1–2 h、装配 3–4 h、调试 1 h（打印可以同时进行） |
| 难度 | 中等偏易：主要是焊导线；有两颗小贴片 MOS 管，不想焊贴片可以换成品模块 |

**原需求三条提问的 DIY 答案**

1. **夹具**：自己打印重力夹。按显示器实测厚度生成，前挂钩 + 后臂把屏幕顶边卡住，内侧贴硅胶防滑垫，后臂底部有配重仓。灯体和夹子之间是转轴，靠转轴套的摩擦当阻尼，灯光朝人的方向最多能转约 35°，朝屏幕方向约 20°，任意角度停得住。
2. **氛围灯**：能做，装在灯体背面、朝后上方 35°。WLED 把它限制在约 150 mA，另有 0.25 A 自恢复保险丝兜底，整灯不会超过 900 mA；这个亮度当背景光够用。不想折腾可以先不装，以后再补。
3. **触摸 / 蓝牙**：TTP223 触摸模块约 ¥1 一个。手机控制用 ESP32-C3 自带的 Wi-Fi，不需要额外的蓝牙模块，也不一定要装 App。**注意：WLED 不支持蓝牙控制**，手机要和灯连同一个 2.4 GHz Wi-Fi。

---

## 1. 和原需求的对照

| 原需求 | DIY 做法 | 说明 |
|---|---|---|
| 铝槽主体 45 cm，有效灯带 40 cm | 铝槽切 45 cm，灯带剪 40 cm 居中贴 | 加上电控仓和堵头，整灯约 50 cm；想短一点见 §2.5 |
| 成品重力枢轴夹具，带软胶垫、阻尼转轴 | 3D 打印重力夹 + 卡座，转轴套摩擦当阻尼，硅胶垫防滑 | 按自己显示器尺寸生成 |
| USB-C 5V/1A，硬件和固件限流 ≤ 900 mA | Type-C 母座（带 5.1 kΩ）+ 自恢复保险丝 + 白光限流电阻 + WLED 限流，USB 电流表实测 | 个人做不到芯片级精确限流，用“选型 + 实测 + 保险丝兜底”达到同样效果 |
| 前光 3000–6000K 无级混光，Ra ≥ 90 | 5V 双色温 COB 灯带（标 Ra ≥ 90）+ WLED 的 PWM CCT 输出 | 显色指数取决于灯带本身，买带检测图的 |
| 背光 WS2812B 同时异色 | WS2812B 5V 灯带 20 颗，分两段装在打印导轨上 | 电流上限约 150 mA |
| 灯体电容触摸 | 2 个 TTP223，贴在电控仓顶面内侧 | 只能隔着塑料感应，隔不了铝 |
| 蓝牙 / Wi-Fi 手机控制 | WLED 走 Wi-Fi：手机浏览器或 WLED App | 不支持蓝牙 |
| 支持实体按钮扩展 | 预留 GPIO10，接一个轻触开关即可 | — |

---

## 2. 3D 打印件

### 2.1 零件一览

| 零件 | 数量 | 作用 | 打印摆放（导出时已摆好） |
|---|---|---|---|
| 重力夹 `clamp` | 1 | 挂在显示器顶边；前挂钩 + 后臂卡住屏幕，前上方是转轴，后臂底部是配重仓 | 侧面朝下平放 |
| 灯体卡座 `saddle` | 1 | 套在铝槽上，后面的转轴套套在夹子的转轴上 | 侧面朝下平放 |
| 电控仓 `bay` | 1 | 插在铝槽左端，装主控、电源件和两个触摸模块；顶面有两个触摸键图标 | 外端朝下立着 |
| 电控仓端盖 `usb_cap` | 1 | 插在电控仓外端，装 Type-C 母座 | 端面朝下 |
| 右堵头 `cap` | 1 | 封住铝槽右端 | 端面朝下 |
| 背光导轨 `rail` | 2 | 粘在铝槽后壁，让背光灯带朝后上方 35° | 贴铝槽的那一面朝下 |
| 背光扩散条 `diffuser`（可选） | 2 | 盖在背光灯带上，让墙上的光更柔和 | 平放，用白色或半透明耗材 |
| 试配件 `test_plug` / `test_saddle` / `test_hinge` | 各 1 | 正式打印前试松紧 | 已摆好 |

所有零件都**不需要支撑**。

### 2.2 打印设置

| 项目 | 建议 |
|---|---|
| 材料 | **PETG**（PLA 在夏天的显示器顶上会慢慢变形；ASA / ABS 也可以） |
| 层高 | 0.2 mm（电控仓想更细可以 0.16 mm） |
| 墙数 | 夹子、卡座 4 层；其他 3 层 |
| 填充 | 夹子、卡座 40%（gyroid）；其他 15–20% |
| 颜色 | 电控仓和堵头建议和铝槽颜色接近（银灰 / 黑）；扩散条用白色或半透明 |
| 防滑垫 | 买 1 mm 背胶硅胶垫剪成小块贴在夹口内侧；有 TPU 也可以自己打 |

### 2.3 用模型文件生成自己的 STL

1. 安装 OpenSCAD（免费，openscad.org，2021.01 或更新版本）。
2. 打开 `cad/monitor-light-bar.scad`，菜单 **窗口 → 定制器（Window → Customizer）**。
3. 填尺寸（下表），其余参数先不动。
4. 在 `part` 里选一个零件 → 按 **F6** 渲染 → **文件 → 导出 → STL**。
5. 控制台会显示夹口宽度、俯仰范围、整灯长度，以及尺寸不合理时的警告。

`cad/stl/` 里是默认尺寸（铝槽 25 × 15 mm、显示器厚 15 mm）导出的 STL。**你的尺寸和默认值不一样时，必须用自己的尺寸重新导出**，否则装不上。

| 参数 | 怎么量 |
|---|---|
| `ch_w` 铝槽外宽 | 铝槽前后方向的外宽 |
| `ch_h` 铝槽外高 | 不含灯罩的外高 |
| `ch_wall` 侧壁厚 | 侧壁厚度 |
| `ch_floor` 底板厚 | 贴灯带那一面的厚度 |
| `cover_h` 灯罩凸出高度 | 灯罩凸出铝槽开口多少；平灯罩填 0 |
| `cover_seat` 灯罩卡扣深度 | 从开口边往里量，灯罩卡扣占到多深 |
| `mon_t_top` 显示器顶边厚度 | 顶边往下 5 mm 处的厚度 |
| `mon_t_low` 显示器下方厚度 | 顶边往下 40 mm 处的厚度（背面是斜的就会比上面厚） |
| `lip_drop` 前挂钩深度 | 不要超过屏幕上边框的宽度，默认 5 mm |
| `arm_len` 后臂长度 | 后臂别碰到显示器背后的凸起，默认 40 mm |

### 2.4 先打三个试配件

| 试配件 | 怎么试 | 合适的标准 | 不合适怎么调 |
|---|---|---|---|
| `test_plug` | 插进铝槽一端 | 用手能推进去，倒过来不会掉 | 太紧把 `fit` 加 0.1，太松减 0.1 |
| `test_saddle` | 从铝槽一端套进去 | 能滑动，但不晃 | 同上，调 `fit` |
| `test_hinge` | 把小转轴套沿着转轴推进去，拨动拨片 | 用手能转，松手停得住 | 太松把 `hinge_fit` 减 0.05（可以填负数），太紧加 0.05 |

试配件合适了，再打印正式零件。转轴用久了变松，在转轴上缠一圈电工胶带就能恢复阻尼。

### 2.5 想让整灯短一点

- 默认铝槽 45 cm（照原需求），加上电控仓约 5 cm，整灯约 50 cm。
- 电路已经都在电控仓里，铝槽里不用再留空间。铝槽最短可以切到 41.6 cm（40 cm 灯带 + 两端插头各 8 mm），整灯约 47 cm。
- 铝槽变短后，背光导轨每段也要变短（`rail_len` 改成 150，每段装 9 颗）。

---

## 3. 购物清单

### 3.1 灯体和光源

| 名称 | 淘宝搜索词 | 数量 | 参考价 | 买的时候注意 |
|---|---|---|---|---|
| U 型 LED 铝槽 + 乳白灯罩 | LED 铝槽 乳白罩 定制长度 | 1 根 | ¥10–20 | 外宽 24–30 mm、外高 14–20 mm、内宽 ≥ 18 mm；请商家切 45 cm；堵头不用买 |
| 5V 双色温 COB 灯带 | 5V COB 灯带 双色温 高显色 Ra90 | 0.5–1 m | ¥15–35 | **三线共阳**（+、暖、冷）；宽 5–8 mm；标 Ra ≥ 90，最好有检测图；单色温每米功率 ≤ 8 W 更合适。**不要“两线双色温”**（要专门的驱动） |
| WS2812B 灯带（背光，可选） | WS2812B 5V 灯带 60灯 不防水 | 1 m | ¥10–18 | 5V、每米 60 灯、不防水（IP30，最薄）、宽 10 mm |

### 3.2 控制

| 名称 | 淘宝搜索词 | 数量 | 参考价 | 买的时候注意 |
|---|---|---|---|---|
| ESP32-C3 SuperMini | ESP32-C3 SuperMini 开发板 | 2（1 个备用） | ¥10–16 / 个 | 不焊排针的更薄，直接焊线 |
| N 沟道 MOS 管 | AO3400 MOS管 SOT-23 | 1 包 | ¥3 | 用 2 颗；配 SOT-23 转接板更好焊 |
| SOT-23 转接板 | SOT23 转 DIP 转接板 | 1 包 | ¥3 | — |
| （替代上两项）MOS 驱动模块 | D4184 MOS 驱动模块 | 2 | ¥2–4 / 个 | **不要光耦隔离款**（高频 PWM 跟不上）；体积较大，电控仓要加长 |
| 触摸模块 | TTP223 触摸按键模块 | 3（1 个备用） | ¥1 / 个 | 点动款，3 针；选 15 × 11 mm 左右的小尺寸版（电控仓的定位槽是 16.5 × 12.5 mm） |
| 轻触开关（可选） | 6x6 轻触开关 | 1 包 | ¥2 | 实体按钮扩展用 |

### 3.3 电源与保护

| 名称 | 淘宝搜索词 | 数量 | 参考价 | 用途 |
|---|---|---|---|---|
| Type-C 母座小板 | Type-C 母座 转接板 带5.1K电阻 | 2 | ¥1–2 / 个 | **必须带 5.1 kΩ 电阻**（板上会标 5.1K），否则 C-to-C 线插充电头不出电 |
| 自恢复保险丝 1.1 A | 自恢复保险丝 1.1A 直插 | 1 | ¥0.5 | 总输入短路保护 |
| 自恢复保险丝 0.25 A | 自恢复保险丝 250mA | 1 | ¥0.5 | 背光支路兜底（不装背光可省） |
| 肖特基二极管 1N5819 | 1N5819 | 2 | ¥0.3 | 主控供电，防倒灌 |
| 二极管 1N4007 | 1N4007 | 2 | ¥0.2 | 背光供电降压，解决信号电平问题 |
| 电解电容 220 µF / 10 V | 220uF 10V 电解电容 小体积 | 2 | ¥0.5 | 吸收 Wi-Fi 发射时的电流尖峰（选直径 6.3 mm 以内，电控仓放得下） |
| 1 W 小阻值电阻 | 1W 电阻 0.47 1 1.5 2.2 欧 | 各 2 | ¥3 | 白光限流（实测后决定用哪个） |
| 普通电阻 | 1/4W 电阻 包 | 1 包 | ¥5 | 330 Ω ×1、100 Ω ×2、10 kΩ ×2 |

### 3.4 线材和小件

| 名称 | 数量 | 参考价 | 说明 |
|---|---|---|---|
| 22AWG 硅胶线（红、黑） | 各 1 m | ¥5 | 电源线 |
| 28AWG 硅胶线（多色） | 1 套 | ¥5 | 信号线 |
| 热缩管套装 | 1 套 | ¥5 | 包焊点 |
| 3M VHB 双面胶 | 1 卷 | ¥5 | 粘触摸模块、背光导轨、卡座 |
| 背胶硅胶垫 1 mm | 1 片 | ¥5 | 夹子防滑垫 |
| 铝箔胶带或黑色电工胶带 | 1 卷 | ¥3 | 防眩光遮光 |
| 高温胶带（聚酰亚胺 / Kapton） | 1 卷 | ¥5 | 铝槽导电，伸进铝槽的焊点要包 |
| M6 螺母或钢珠（可选） | 一小把 | ¥3 | 夹子配重仓 |
| PETG 耗材 | 约 90 g | ¥5–10 | 白色或半透明耗材少量，用来打扩散条（可选） |
| USB 线（C-to-C 或 A-to-C，1–1.5 m） | 1 | ¥8 | 最好买带开关的，关灯后可以断电 |

### 3.5 工具（家里没有才买）

| 工具 | 参考价 | 说明 |
|---|---|---|
| 恒温电烙铁 + 焊锡丝 + 助焊剂 | ¥40–80 | — |
| 剥线钳、斜口钳、镊子 | ¥20–30 | — |
| 万用表 | ¥30 | 查短路、量电压 |
| **USB 电流表**（C 口） | ¥20–40 | **必备**，用来确认 ≤ 900 mA |
| **卡尺** | ¥15–30 | **必备**，量铝槽和显示器 |
| 热熔胶枪 | ¥15 | 固定母座、线材、配重 |

---

## 4. 电路与接线

### 4.1 接线总图

```text
                       ┌──────────────────────── 5V 母线 ────────────────────────┐
USB-C 母座 5V ──[自恢复 1.1A]──┤                                                    │
(带 5.1kΩ)                     ├──(+) 220µF (−)── GND                                │
    GND ── 公共地              ├──[1N5819 ▶|]──────────────── ESP32-C3 的 5V 脚     │
                               ├──[自恢复 0.25A]──[1N4007 ▶|]── 背光 WS2812B 的 5V   │
                               └──[限流电阻 0–1.8Ω 1W]────────── 前光 COB 灯带的 +   │

前光 COB 暖(−) ── Q1 漏极 D │ Q1 源极 S ── GND │ Q1 栅极 G ──100Ω── GPIO4，G 另接 10kΩ 到 GND
前光 COB 冷(−) ── Q2 漏极 D │ Q2 源极 S ── GND │ Q2 栅极 G ──100Ω── GPIO5，G 另接 10kΩ 到 GND
背光第 1 段 DIN ──330Ω── GPIO3；第 1 段 DOUT ──跨过夹子的 3 根线── 第 2 段 DIN（5V、GND 也跟着跨过去）
触摸 1（TTP223）：VCC ── 3V3   I/O ── GPIO6   GND ── GND
触摸 2（TTP223）：VCC ── 3V3   I/O ── GPIO7   GND ── GND
实体按钮（可选）：GPIO10 ── 轻触开关 ── GND

所有 GND 接在一起。二极管有色环的一头（负极）朝向负载。
```

### 4.2 ESP32-C3 引脚分配

| 引脚 | 接到 | 说明 |
|---|---|---|
| 5V | 1N5819 负极（正极接 5V 母线） | 主控供电 |
| GND | 公共地 | — |
| 3V3 | 两个 TTP223 的 VCC | 触摸模块用 3.3 V 供电，输出电平才不会超过主控耐压 |
| GPIO3 | 330 Ω → 背光 DIN | 背光数据线 |
| GPIO4 | 100 Ω → Q1 栅极 | 暖白（WLED 里 PWM CCT 的第 1 个引脚） |
| GPIO5 | 100 Ω → Q2 栅极 | 冷白（第 2 个引脚） |
| GPIO6 | 触摸 1 的 I/O | 电控仓靠外端的键（圆环图标） |
| GPIO7 | 触摸 2 的 I/O | 电控仓靠铝槽的键（圆点图标） |
| GPIO10 | 轻触开关，另一端接 GND | 可选 |
| **不要用** | GPIO2、8、9（和启动有关）、20、21（串口） | GPIO8 上还有板载指示灯 |

AO3400 引脚（SOT-23）：1 = 栅极 G，2 = 源极 S，3 = 漏极 D（单独一边的那只脚是 D）。

**如果用 D4184 模块代替 AO3400**：模块的 PWM 输入接 GPIO4 / GPIO5，输入 GND 接地；VIN+ / VIN− 接 5V 和 GND；OUT− 接灯带的暖 / 冷负极。**灯带的 + 要从限流电阻那一路接，不要接模块的 OUT+**（OUT+ 直通 5V，会绕过限流电阻）。模块比较大，`bay_len` 要加到 65 左右。

### 4.3 每个零件为什么要装

| 零件 | 作用 |
|---|---|
| Type-C 母座上的 5.1 kΩ | 告诉充电头“我要 5V”。没有它，C-to-C 线插充电头不会出电 |
| 自恢复保险丝 1.1 A | 短路时自动断开，冷却后恢复 |
| 限流电阻 | 给前光定死最大电流，这就是**硬件限流**；阻值由实测决定（见 §5） |
| 1N5819 | 刷机时用电脑给主控供电，防止电脑和外部电源互相倒灌，也防止电脑去带动灯带 |
| 自恢复保险丝 0.25 A | 万一固件失灵、背光全白最亮，会自动断开，冷却后恢复 |
| 1N4007 | 把背光供电降到约 4.2 V。WS2812B 在 5V 供电时，3.3 V 的数据信号处在临界值，容易乱闪；降压后就稳了 |
| 220 µF 电容 | 吸收 Wi-Fi 发射时的电流尖峰，防止主控重启 |
| 100 Ω + 10 kΩ | 100 Ω 保护引脚；10 kΩ 保证上电瞬间前光不乱亮 |
| 330 Ω | 减少背光数据线上的振铃，保护第一颗灯珠 |

---

## 5. 功率预算和电流实测

### 5.1 预算

| 部分 | 电流 | 怎么保证 |
|---|---|---|
| ESP32-C3 + Wi-Fi | 约 100–120 mA | 实测 |
| 触摸模块 × 2 | < 1 mA | — |
| 前光（最亮） | **≤ 550 mA** | 限流电阻定死（硬件）；WLED 的 CCT blending 保持 0%，中间色温时两路交替点亮，电流不会翻倍 |
| 背光（最亮） | **≤ 150 mA** | WLED 限流（固件）+ 0.25 A 自恢复保险丝（硬件兜底） |
| **合计** | **≤ 820 mA（约 4.1 W）** | 低于 900 mA ✓ |

- **不装背光**的话，前光上限可以放到约 700 mA，亮约 25%。
- **亮度预期**：前光约 2.7 W，灯下 45 cm 中心大约 300 lx 上下，看书写字够用，比 5 W 以上的商用挂灯暗一些。这是 5V/900 mA 这个供电条件决定的。

### 5.2 实测方法（USB 电流表串在充电头和灯之间）

| 第几步 | 状态 | 记录 | 合格 |
|---|---|---|---|
| 1 | 灯全关（Wi-Fi 连着） | 待机电流 I₀ | 约 80–130 mA |
| 2 | 前光 100%，色温拉到最暖 | I_暖 | — |
| 3 | 前光 100%，色温拉到最冷 | I_冷 | — |
| 4 | 前光电流 = max(I_暖, I_冷) − I₀ | — | ≤ 550 mA |
| 5 | 前光最亮 + 背光彩虹最亮 | 总电流 | ≤ 850 mA |

### 5.3 前光超了怎么办：串限流电阻

5V 灯带内部是“LED + 电阻”的结构，在正极串一个小电阻就能把电流压下来。估算公式（单位 A、Ω）：

> **R ≈ 2.1 ÷ I目标 − 2.1 ÷ I实测**

| 实测前光电流 | 目标 550 mA 需要的电阻 | 选用 |
|---|---|---|
| 650 mA | ≈ 0.6 Ω | 0.47 Ω |
| 800 mA | ≈ 1.2 Ω | 1 Ω（或 1 Ω + 0.22 Ω 串联） |
| 1000 mA | ≈ 1.7 Ω | 1.5 Ω |

- 实测已经 ≤ 550 mA 就不用电阻，用一根线短接即可。
- 装上电阻后**再测一次**，公式只是估算，以实测为准。
- 电阻会发热（约 0.3 W），用 1 W 规格、套热缩管，别贴着打印件（PETG 受热会软）。
- 偷懒的办法：WLED 里把 Global brightness factor（全局亮度系数）调到 80–90%。但这属于固件限流，而且背光也会一起变暗。

### 5.4 供电注意

- **最稳的是 5V / 1A 以上的手机充电头**。快充头也没关系：这个灯不会和充电头协商快充，只会拿到 5V。
- 显示器上的 USB 口如果是 USB 2.0（一般是黑色或白色口），只能给 500 mA，开到最亮时灯可能会重启。这种情况把 Global brightness factor 调到 50% 左右，或者改插充电头。
- 关灯后 Wi-Fi 还在工作，待机约 0.5 W。不想要待机耗电，就用带开关的 USB 线。

---

## 6. 制作步骤

> 原则：**先在桌面上把电路全部接好、测好，再装进外壳。** 装进去以后再改会很麻烦。打印可以和刷机、试接同时进行。

### 第 1 步：给 ESP32-C3 刷 WLED（只插主控板）

1. 用数据线把 ESP32-C3 SuperMini 插到电脑（先别接任何其他东西）。
2. 用 Chrome 或 Edge 打开 `install.wled.me`，选最新稳定版（Stable），点 Install，在弹窗里选这块板子的串口，等进度走完。
3. 找不到串口：换一根能传数据的线（有些线只能充电）；或者**按住板子上的 BOOT 键再插 USB**，然后松开。SuperMini 用芯片自带的 USB，Windows 10/11 不用装驱动。
4. 刷完后，手机连 Wi-Fi 热点 `WLED-AP`（密码 `wled1234`），浏览器打开 `4.3.2.1`，进 WiFi Setup 填家里 Wi-Fi，保存。
5. 之后用 WLED App 自动搜索这盏灯，或在路由器后台的设备列表里找名字带 wled 的设备，记下 IP。
6. **连不上家里 Wi-Fi**：
   - ESP32-C3 只支持 2.4 GHz，路由器的 5 GHz 网络搜不到；
   - SuperMini 有些批次发射功率太高会掉线：在 WiFi Setup 里把 **Max. TX power** 改成 8.5 dBm 再试。

### 第 2 步：量尺寸，打试配件

1. 按 §2.3 的表用卡尺量铝槽和显示器，填进模型文件。
2. 导出并打印三个试配件，按 §2.4 调好 `fit` 和 `hinge_fit`。

### 第 3 步：打印正式零件

按 §2.1 和 §2.2 打印：重力夹、卡座、电控仓、电控仓端盖、右堵头、背光导轨 ×2（扩散条可选）。

### 第 4 步：桌面试接

按 §4 接线图，在桌上用焊线或鳄鱼夹把所有东西连起来，顺序：

1. 先接 Type-C 母座 → 自恢复保险丝 → 电容 → 1N5819 → 主控，上电确认主控正常、Wi-Fi 能连。
2. 再接两个触摸模块，按 §7 配好按钮，摸一下确认有反应。
3. 再接前光灯带和两颗 MOS 管，确认能调亮度、调冷暖。
4. 最后接背光，确认颜色和效果正常。

每接一部分就上电测一次，出问题容易定位。

### 第 5 步：按 §7 把 WLED 设置好

### 第 6 步：用 USB 电流表实测，按 §5 决定限流电阻

### 第 7 步：装前光（含防眩光）

1. 灯带在剪切标记处剪 40 cm，一端焊三根线（+、暖、冷），焊点套热缩管，再包一层高温胶带（铝槽导电）。
2. 灯带贴在铝槽底板正中间，两端各留约 25 mm（45 cm 铝槽）；焊线的一端朝电控仓。
3. 盖上灯罩。
4. **防眩光**：在灯罩内侧**靠屏幕的一边**，沿长度方向贴一条 4–6 mm 宽的铝箔胶带（或黑胶带），挡住射向屏幕的光。装好后关掉显示器，看黑屏上有没有一条反光带；有就把遮光条再加宽 1–2 mm。

### 第 8 步：装电控仓

1. 两个 TTP223 用 VHB 双面胶贴进电控仓顶壁内侧的两个定位槽，**带圆形感应区的那一面贴紧塑料**，中间不能有空气隙。靠外端的是触摸 1（圆环图标），靠铝槽的是触摸 2（圆点图标）。
2. Type-C 母座对准电控仓端盖上的方孔，从内侧用热熔胶固定，插拔几次确认不晃。
3. 电源件（保险丝、二极管、电容、限流电阻、两颗 MOS 管）尽量直接焊在线上，套热缩管排整齐，不用洞洞板也塞得下；实在塞不下就把 `bay_len` 改成 60 重新打印电控仓。
4. ESP32-C3 平放在电控仓底部（灯罩一侧），用双面胶固定。电控仓是塑料的，天线朝哪边都可以。
5. 前光的三根线从电控仓的插头里穿进铝槽；背光的三根线从电控仓后壁的小孔穿出来。
6. 电控仓插头插进铝槽左端，端盖插进电控仓外端。插头偏松可以加一点热熔胶。

### 第 9 步：装卡座、找平衡点、装夹子

1. 拔下右堵头，把卡座从铝槽右端套进去（转轴套朝后、朝下），再插回右堵头。
2. **找平衡点**：把整根灯体横放在一根手指上左右挪，找到能平放不倒的位置（电控仓那头重，平衡点一般在中点往电控仓方向偏 2–3 cm）。把卡座挪到这个位置，底面贴一小块 VHB 固定。
3. 夹子的前挂钩和后臂内侧贴 1 mm 硅胶防滑垫。想更稳就在配重仓里塞几颗 M6 螺母或钢珠，用热熔胶封口。
4. 把卡座的转轴套对准夹子的转轴，从没有挡片的那一端推进去，推到底。

### 第 10 步：装背光（可选）

1. 背光灯带剪成两段，每段 10 颗（约 167 mm）。灯带上有箭头，**数据线接在箭头起点那一头**（DIN）。
2. 两段灯带分别贴进两条背光导轨的槽里；想更柔和就再盖一条扩散条（用透明胶或双面胶固定）。
3. 导轨用 VHB 粘在铝槽后壁下半部，卡座左右各一条，避开卡座。
4. 电控仓出来的三根线接第 1 段的 DIN 端；第 1 段的 DOUT 端用三根线（5V、GND、数据）跨过卡座接第 2 段的 DIN 端。

### 第 11 步：挂上显示器，最终测试（见 §8）

---

## 7. WLED 设置（照抄即可）

WLED 界面是英文的，下面标出了每一项的英文原名。

### 7.1 LED 设置（Config → LED Preferences）

| 设置 | 填什么 |
|---|---|
| 输出 1：类型 | WS281x RGB |
| 输出 1：GPIO / 长度 / 颜色顺序 | GPIO 3；Length **20**；颜色不对就把 Color Order 在 GRB / RGB 之间换 |
| 输出 2：类型 | PWM CCT |
| 输出 2：两个 GPIO | 第一个 4（暖白），第二个 5（冷白）。调色温方向反了就对调 |
| 输出 2：Clock | Normal（默认频率在万赫兹级别，没有频闪） |
| Make a segment for each output | 勾选（分段 0 = 背光，分段 1 = 前光） |
| Enable automatic brightness limiter | 勾选 |
| Maximum PSU Current | **270 mA**（WLED 会自动扣掉 120 mA 给主控，剩约 150 mA 给背光） |
| CCT blending | **0%**（不要改成正数，否则中间色温时电流翻倍） |
| Global brightness factor | 100%（插 USB 2.0 口时调到约 50%） |
| Button 0 | GPIO 6，类型 **Push inverted**（TTP223 触摸时输出高电平） |
| Button 1 | GPIO 7，类型 Push inverted |
| Button 2（可选实体按钮） | GPIO 10，类型 Pushbutton |

> 前光的自动限流（brightness limiter）对 PWM 输出不起作用，这是 WLED 的设计，所以前光靠 §5 的限流电阻。
> 如果 WLED 默认把按钮放在别的引脚，按上表改掉。

### 7.2 Wi-Fi（Config → WiFi Setup）

- 只填家里的 2.4 GHz Wi-Fi。
- 连接不稳就把 Max. TX power 改成 8.5 dBm。

### 7.3 预设（主界面 Presets → + Preset）

新建预设时**取消勾选 Use current state**，在 **API command** 里粘贴下表内容，在 **Save to ID** 里填编号。

| ID | 名称 | API command |
|---|---|---|
| 1 | 专注（约 6000K） | `{"on":true,"seg":[{"id":1,"on":true,"bri":255,"cct":255,"col":[[255,255,255,255]]}]}` |
| 2 | 办公（约 5000K） | `{"on":true,"seg":[{"id":1,"on":true,"bri":210,"cct":170,"col":[[255,255,255,255]]}]}` |
| 3 | 阅读（约 4000K） | `{"on":true,"seg":[{"id":1,"on":true,"bri":160,"cct":85,"col":[[255,255,255,255]]}]}` |
| 4 | 夜间（约 3000K） | `{"on":true,"seg":[{"id":1,"on":true,"bri":40,"cct":0,"col":[[255,255,255,255]]}]}` |
| 11 | 背光·护眼暖白 | `{"seg":[{"id":0,"on":true,"bri":80,"fx":0,"col":[[255,180,110]]}]}` |
| 12 | 背光·静态蓝紫 | `{"seg":[{"id":0,"on":true,"bri":110,"fx":0,"col":[[90,60,255]]}]}` |
| 13 | 背光·呼吸 | `{"seg":[{"id":0,"on":true,"bri":110,"fx":2,"col":[[255,120,40]]}]}` |
| 14 | 背光·彩虹 | `{"seg":[{"id":0,"on":true,"bri":110,"fx":9}]}` |
| 20 | 场景循环 | `{"ps":"1~4~"}` |
| 21 | 背光效果循环 | `{"ps":"11~14~"}` |
| 22 | 背光开关 | `{"seg":[{"id":0,"on":"t"}]}` |
| 23 | 夜灯（30 分钟渐暗关灯） | `{"on":true,"nl":{"on":true,"dur":30,"mode":1,"tbri":0}}` |

- `cct` 0 = 全暖（3000K），255 = 全冷（6000K），中间是两路混合，标的色温是大概值。
- 场景里的 `"col":[[255,255,255,255]]` 是把前光分段设成全白。不写这一项的话，前光分段默认是橙色，在某些白光计算模式下前光会不亮。刷机后第一次按场景键，前光就会正常。
- `fx` 0 = Solid（纯色），2 = Breathe（呼吸），9 = Rainbow（彩虹）。想换别的效果，在主界面选好后看效果列表里的名字即可。

### 7.4 按钮动作（Config → Time & Macros → Button actions）

| 按钮 | Short press（短按） | Long press（长按） | Double press（双击） |
|---|---|---|---|
| Button 0（触摸 1，圆环） | 0（默认：开 / 关） | 23 夜灯 | 22 背光开关 |
| Button 1（触摸 2，圆点） | 20 场景循环 | 21 背光效果循环 | 0 |
| Button 2（实体按钮） | 0（开 / 关） | 23 夜灯 | 22 背光开关 |

- 设了双击后，短按会有约 0.3 秒延迟（在等你是不是要按第二下），属于正常现象。
- 按过“背光效果循环”或“夜灯”之后再按场景键，会从“专注”重新开始，也是正常的。

### 7.5 手机控制

- **不装 App**：手机浏览器打开灯的 IP，然后“添加到主屏幕”，用起来和 App 一样。
- **装 App**：iPhone 在 App Store 搜 WLED；安卓可以从 WLED 官方 GitHub 下载安装包。
- 可以调亮度、色温、背光颜色和效果，设定时开关灯；也能接入 Home Assistant。

---

## 8. 测试清单

| 项目 | 方法 | 合格 |
|---|---|---|
| 无短路 | 上电前用万用表量 5V 和 GND 之间的电阻 | 不是 0（大于几百欧） |
| 电流 | 按 §5.2 测 5 个状态 | 前光 ≤ 550 mA，总电流 ≤ 850 mA |
| 色温 | 场景 1–4 依次切换 | 冷暖变化明显，方向正确 |
| 频闪 | 手机相机对着灯拍，亮度从 100% 调到 5% | 屏幕上看不到滚动的黑条纹 |
| 眩光 | 关显示器，坐姿看黑屏 | 看不到反光带 |
| 触摸 | 每个键短按 / 长按 / 双击各 10 次 | 不漏触、不误触 |
| 夹子 | 挂好后轻推灯体前后左右 | 不滑、不晃、不往一边歪 |
| 转轴 | 把灯头调到最低、水平、最高各停 1 分钟 | 都停得住 |
| Wi-Fi | 关灯 1 小时后用手机开灯 | 能正常响应 |
| 温度 | 最亮连续开 30 分钟，摸铝槽和电控仓 | 手能一直握住（约 45 °C 以下），打印件不变软 |
| C-to-C 线 | 用 C-to-C 线插手机充电头 | 能正常亮（验证 5.1 kΩ） |

---

## 9. 常见问题

| 现象 | 原因和办法 |
|---|---|
| 网页刷机找不到设备 | 换能传数据的线；按住 BOOT 再插 USB；用 Chrome 或 Edge 电脑版 |
| 连不上 Wi-Fi | 只支持 2.4 GHz；Max. TX power 改 8.5 dBm |
| 背光乱闪或颜色不对 | 检查 1N4007 是否装了、方向是否对；数据线是否接在 DIN 端；两段之间的跨线是否接对；所有 GND 是否接在一起；Color Order 换成 GRB 或 RGB |
| 只有第 1 段背光亮 | 第 1 段 DOUT → 第 2 段 DIN 的跨线断了或接反了 |
| 调色温方向反了 | LED 设置里 PWM CCT 的两个 GPIO 对调 |
| 低亮度时手机拍有条纹 | Clock 用 Normal 或 Fast；MOS 模块不能用光耦款 |
| 触摸没反应 | 确认按钮类型是 Push inverted；TTP223 接的是 3V3；感应面贴紧电控仓顶壁 |
| 触摸自己乱触发 | 上电时别碰；模块背面电容焊盘加 10–20 pF；信号线远离 MOS 管和灯带负极线 |
| 插头或卡座太紧 / 太松 | 调 `fit`（0.1 一档）重新导出；偏松也可以加一点热熔胶或 VHB |
| 转轴太松，灯头往下掉 | `hinge_fit` 减 0.05 重新打卡座；临时办法是在转轴上缠一圈电工胶带 |
| 夹子在显示器上晃 | 重新量显示器厚度；防滑垫厚度和 `pad_t` 要一致；背面是斜的就把 `mon_t_low` 填准 |
| 灯体往一边歪 | 卡座没装在平衡点，按第 9 步重新找；或者在右堵头里塞几颗螺母配重 |
| 插显示器 USB 口一开最亮就重启 | USB 2.0 口只有 500 mA：改插充电头，或把 Global brightness factor 调到 50% |
| 设置改乱了找不到灯 | 灯连不上 Wi-Fi 时会自己打开 WLED-AP 热点，连上去重新设置 |
| 更新固件 | Config → Security & Updates → Manual OTA Update，上传新的 .bin，不用拆灯 |

---

## 10. 安全

- 整灯是 5V 低压，没有触电危险；主要风险是**短路发热**。铝槽导电，伸进铝槽的焊点一定要包好。
- 电解电容有正负极（长脚为正），接反会鼓包。
- 二极管有色环的一头是负极，方向接反背光或主控会不亮。
- 第一次通电在桌上进行，用 USB 电流表看着；电流异常大（超过 1 A）立刻拔掉。
- 刷机或插电脑调试时，**先拔掉灯的供电线**，只让电脑给主控供电。
- 打印件用 PETG 或更耐热的材料；限流电阻别贴着打印件。

---

## 11. 可选升级

| 升级 | 做法 | 难度 |
|---|---|---|
| 更亮 | 换 24V 双色温灯带 + 5V 转 24V 升压模块（MT3608 类），同样 4.5 W 亮约 30%；要会调升压模块的输出电压，电控仓要加长 | 中 |
| TPU 防滑垫 | 有 TPU 耗材的话，按夹口尺寸打 1 mm 垫片代替硅胶垫 | 低 |
| 实体旋钮 | WLED 有旋转编码器扩展（usermod），需要自己编译固件 | 高 |
| 自动亮度 | 加光照传感器，同样需要编译带 usermod 的固件 | 高 |
| 智能家居 | WLED 原生支持 Home Assistant，局域网内自动发现 | 低 |

---

## 附：没有 3D 打印机时的替代

买一个 ¥30–60 的平价成品挂灯（重力夹、灯头能转、铝合金外壳、堵头用螺丝固定），保留外壳、灯罩、堵头、夹子和转轴，里面换成本方案的电路。触摸模块贴在塑料堵头内侧，主控放在外壳内的灯带上方，天线朝塑料堵头。
