Huliang2597/byd-music1/cad/preview/w_back.png

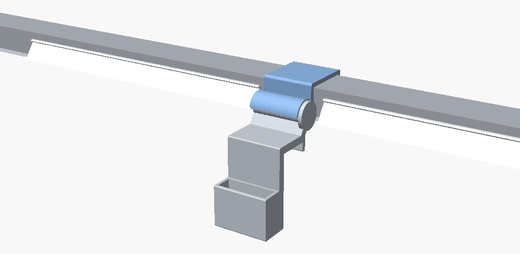
cad/preview/w_back.png
