Huliang2597/byd-music1/cad/preview/x_bay.png

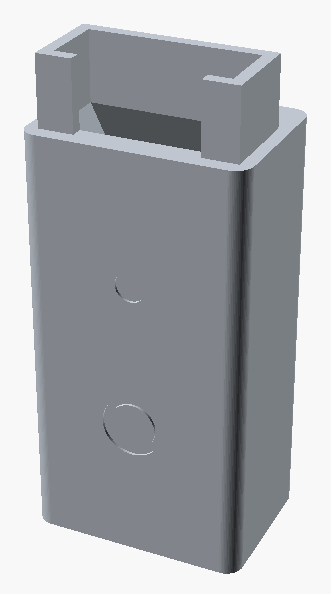
cad/preview/x_bay.png
