Huliang2597/byd-music1/cad/preview/x_cap.png

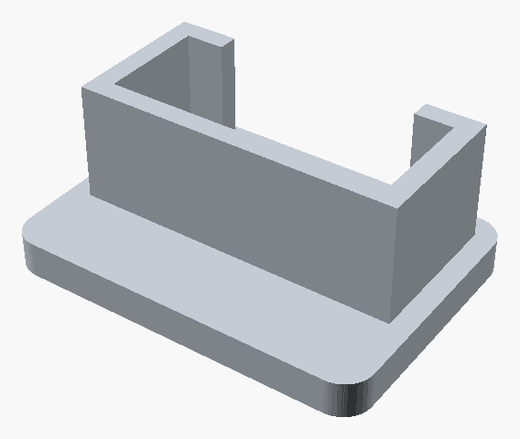
cad/preview/x_cap.png
