Huliang2597/byd-music1/cad/preview/x_clamp.png

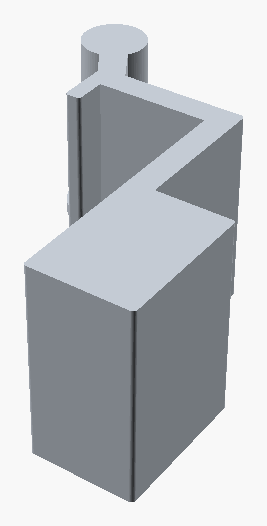
cad/preview/x_clamp.png
