Huliang2597/byd-music1/cad/preview/x_hinge.png

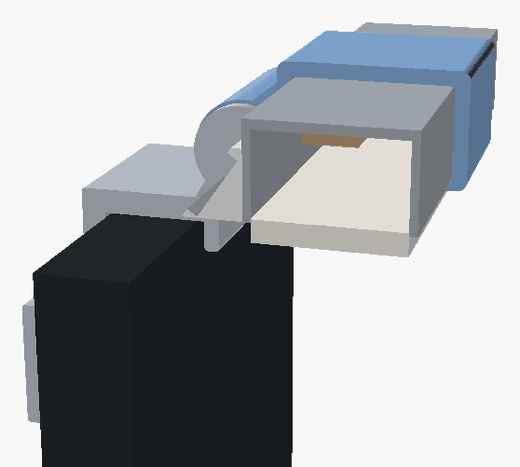
cad/preview/x_hinge.png
