Huliang2597/byd-music1/cad/preview/x_rail.png

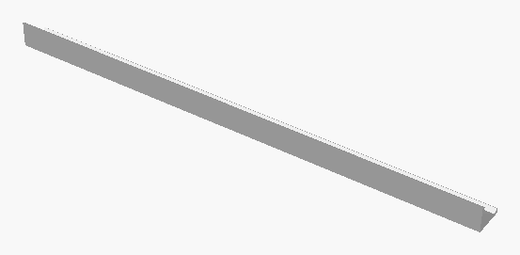
cad/preview/x_rail.png
