Huliang2597/byd-music1/cad/preview/x_saddle.png

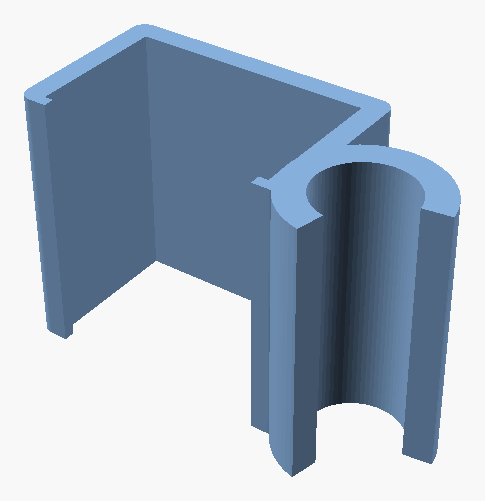
cad/preview/x_saddle.png
