Huliang2597/byd-music1/cad/preview/x_usb_cap.png

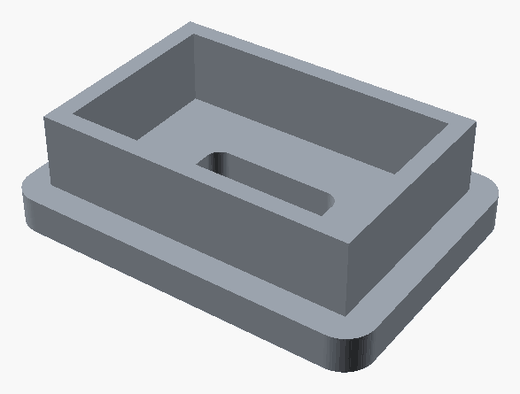
cad/preview/x_usb_cap.png
