Huliang2597/byd-music1/cad/stl/rail.stl

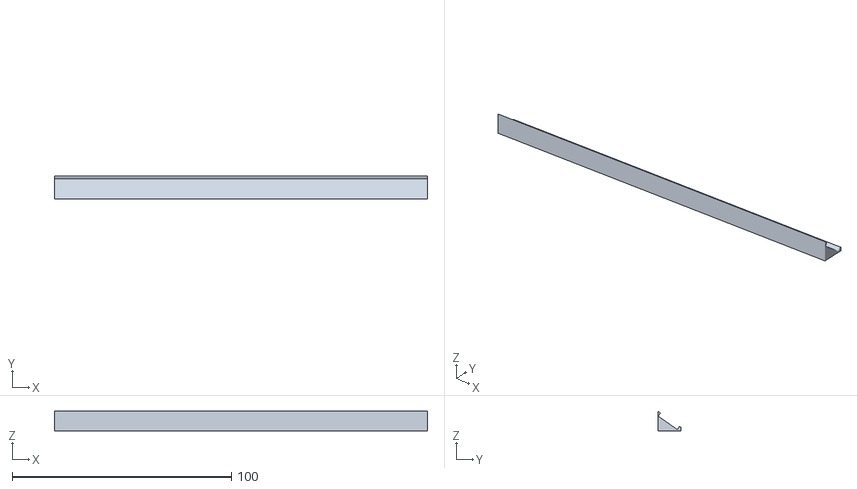
[picture p9: CAD file, 2026-10-25]
cad/stl/rail.stl
170.0 x 10.6 x 9.06
