Huliang2597/byd-music1/cad/stl/diffuser.stl

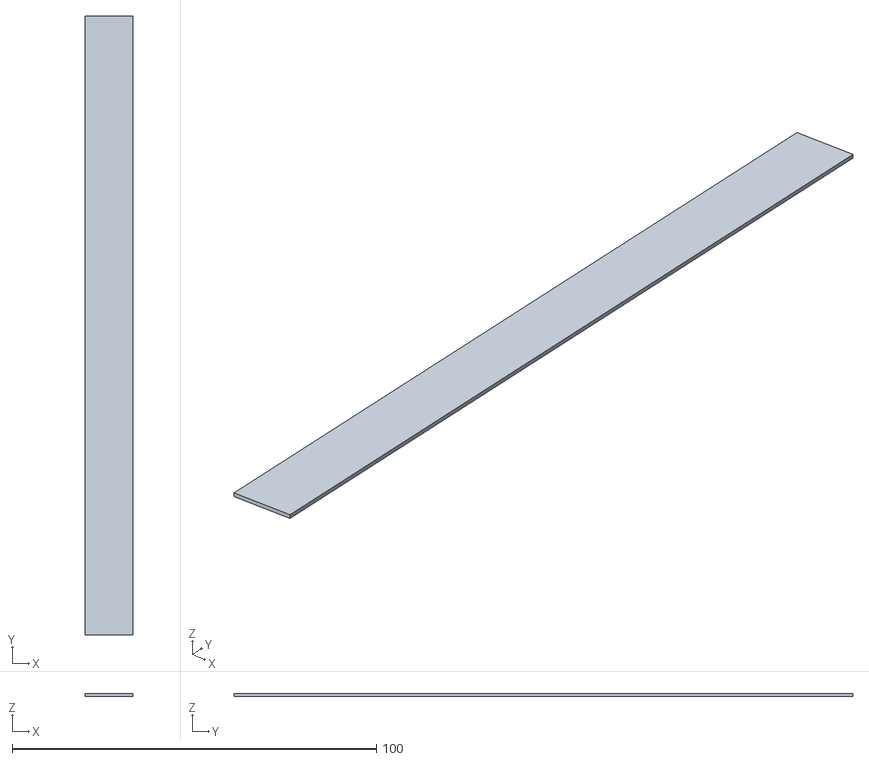
[picture p10: CAD file, 2026-10-25]
cad/stl/diffuser.stl
13.2 x 170.0 x 0.8
