Huliang2597/byd-music1/cad/stl/test_hinge.stl

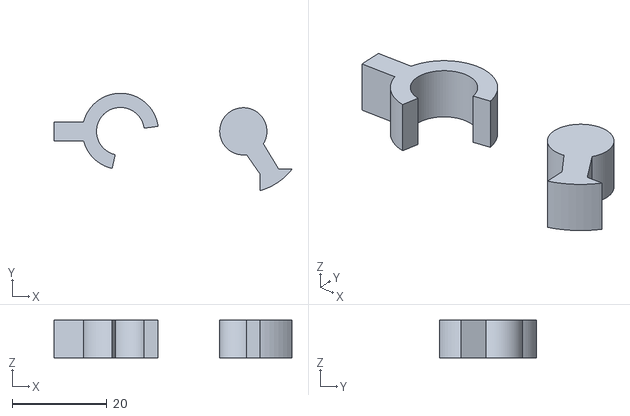
[picture p11: CAD file, 2026-10-25]
cad/stl/test_hinge.stl
50.3 x 20.6 x 8.00
