Huliang2597/byd-music1/cad/stl/saddle.stl

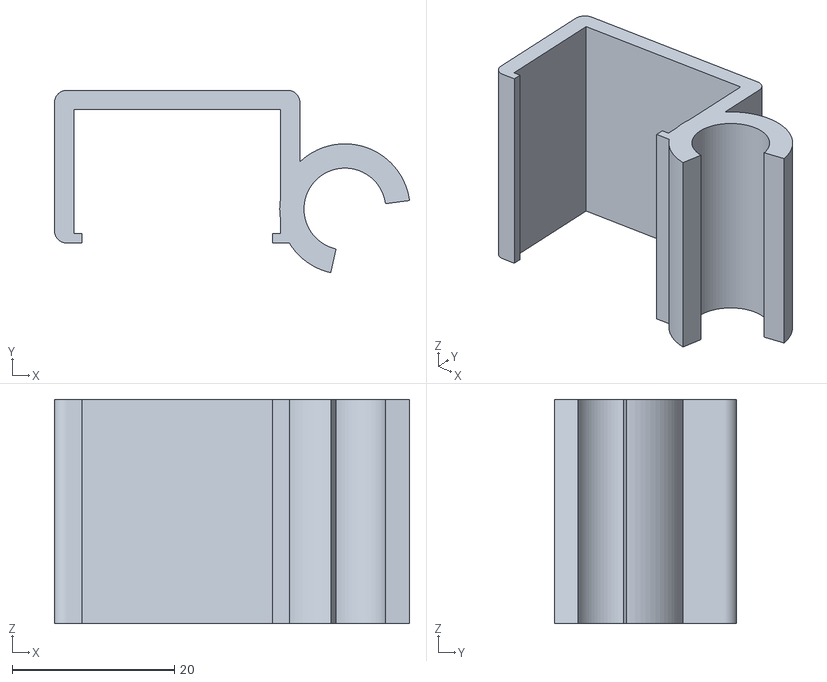
[picture p12: CAD file, 2026-10-25]
cad/stl/saddle.stl
43.8 x 22.5 x 27.7
