Huliang2597/byd-music1/cad/stl/bay.stl

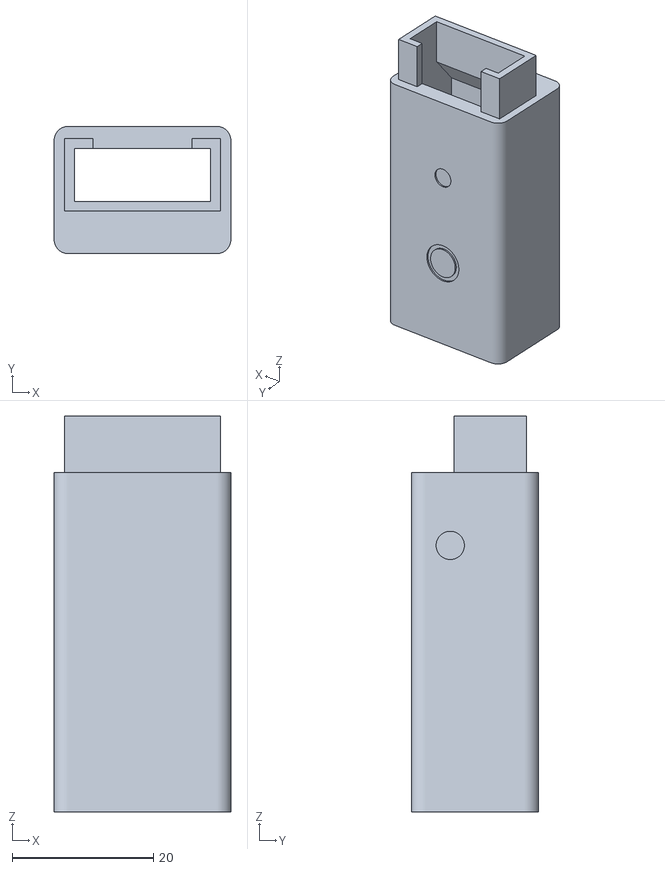
[picture p13: CAD file, 2026-10-25]
cad/stl/bay.stl
25.0 x 18.0 x 56.0
