Huliang2597/byd-music1/cad/stl/cap.stl

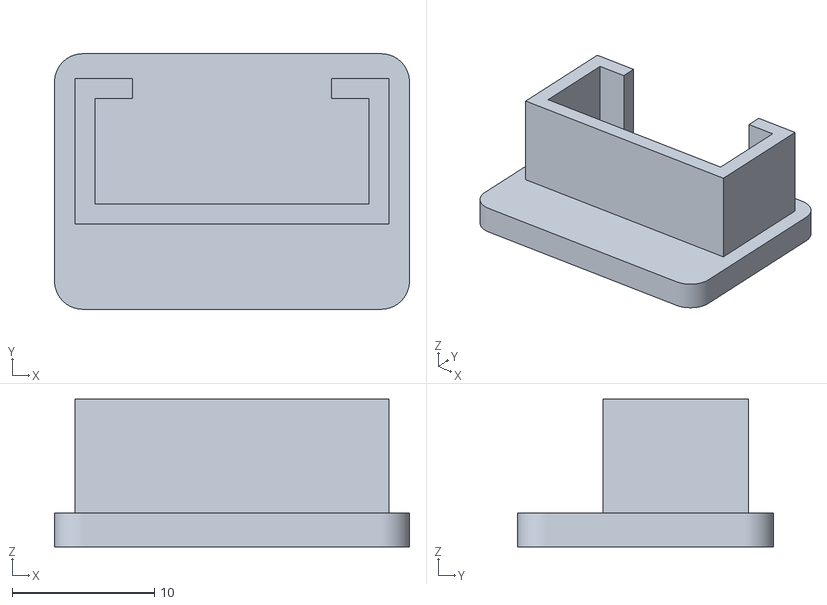
[picture p14: CAD file, 2026-10-25]
cad/stl/cap.stl
25.0 x 18.0 x 10.4
