Huliang2597/byd-music1/cad/stl/test_saddle.stl

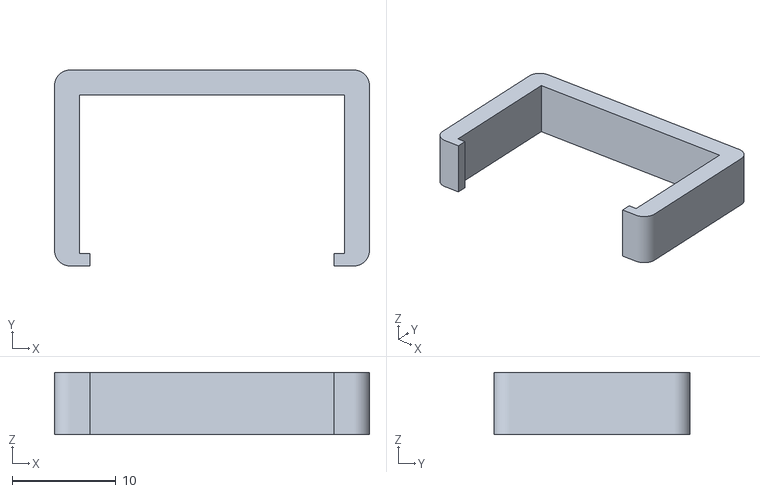
[picture p15: CAD file, 2026-10-25]
cad/stl/test_saddle.stl
30.3 x 18.9 x 6.00
