Huliang2597/byd-music1/cad/stl/clamp.stl

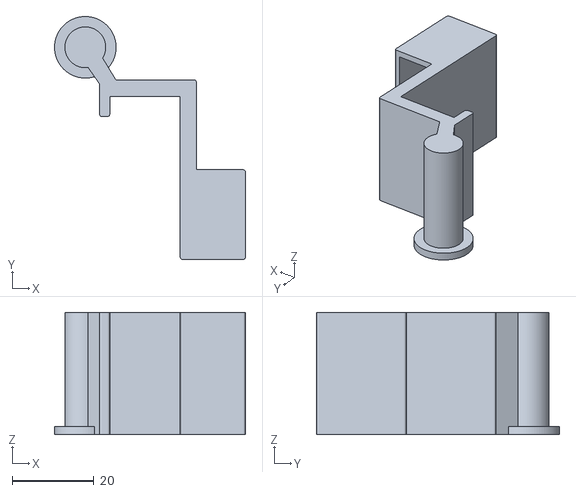
[picture p16: CAD file, 2026-10-25]
cad/stl/clamp.stl
46.8 x 59.5 x 30.0
