Huliang2597/byd-music1/cad/stl/test_plug.stl

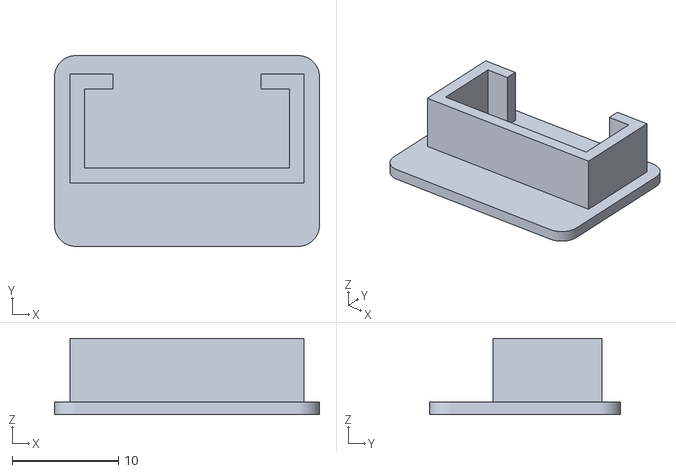
[picture p17: CAD file, 2026-10-25]
cad/stl/test_plug.stl
25.0 x 18.0 x 7.20
