Huliang2597/byd-music1/cad/stl/usb_cap.stl

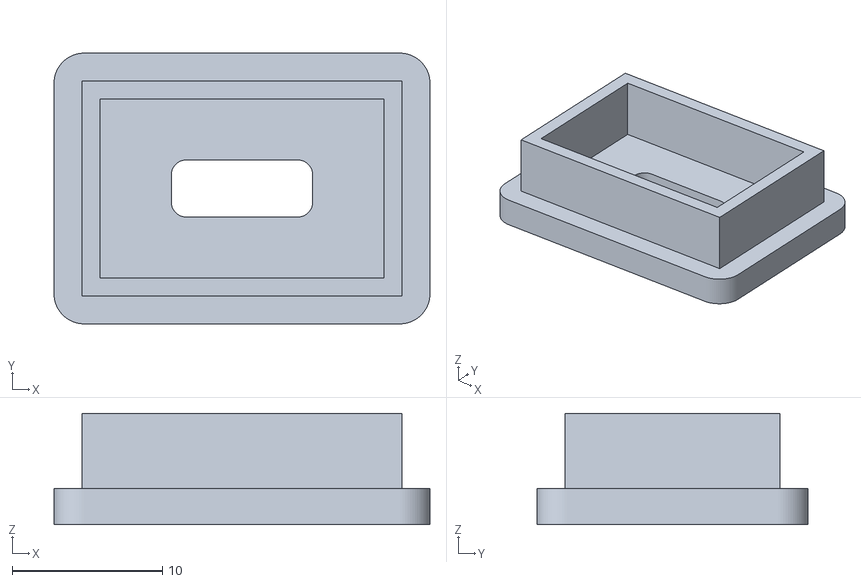
[picture p18: CAD file, 2026-10-25]
cad/stl/usb_cap.stl
25.0 x 18.0 x 7.40
