Huliang2597/byd-music1/cad/preview/x_tests.png

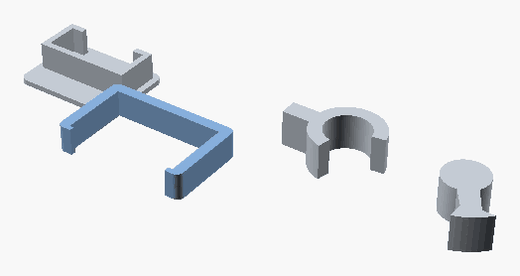
cad/preview/x_tests.png
