Huliang2597/byd-music1/(commit log)

2026-10-25 Add production-ready spec for monitor light bar
    Covers clamp selection, asymmetric optics, dual-CCT drive topology,
    USB-C 5V/900mA power budget with per-branch hardware caps, optional
    rear ARGB bias light, touch/BLE controls, firmware, structure, BOM,
    certification, test and production plan.
    Claude-Session: https://claude.ai/code/session_01B6LEwuwTS2KVTfP6VxtMTL
2026-10-25 Add DIY build guide for the monitor light bar
    A one-person build using retail parts only: donor screen-bar housing and
    gravity clamp, ESP32-C3 SuperMini running WLED, 5V dual-CCT COB strip,
    WS2812B rear bias light and TTP223 touch keys. Covers shopping list,
    wiring, current budget with measurement steps, assembly, WLED settings
    and presets, tests and troubleshooting.
    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
2026-10-25 Switch DIY guide to 3D-printed parts and add parametric models
    Adds an OpenSCAD model for the gravity clamp, bar saddle with friction
    hinge, electronics bay with Type-C end cap and touch-key pockets, end cap
    and rear bias-light rails, plus fit-test pieces. Default-size STLs and
    preview renders are included. The DIY guide now uses an aluminium channel
    with these printed parts; electronics move into the printed bay and the
    rear light becomes two 10-LED segments.
    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
